hye071/P4P_TMR/Report/P4P_Report_v4.pdf

### Department of Electrical, Computer, and Software Engineering The University of Auckland

# Characterisation, Field Modelling, and Radiation Testing of a Commercial Tunnelling Magnetoresistance (TMR) Sensor for CubeSat Attitude Determination and Control

## Final Year Technical Report

### Sam Ye

### Supervisor: Dariusz Kacprzak

### Project Partner: Daniel Tieu

### [TODO: insert submission date]

## Abstract

Tunnelling magnetoresistance (TMR) sensors offer chip-scale, high-sensitivity magnetic field detection that is attractive for CubeSat attitude determination and control, yet the technology has little space heritage, and little device-level data exists on how a commercial part behaves when it is saturated by a strong field or after irradiation. This report characterises a low-cost commercial TMR sensor, the CT100, using two custom printed circuit boards: a standalone board exposing the raw bridge output, and an integrated board that adds an STM32 microcontroller and an independent current-sense reference to drive and log a controlled test field from a PCB trace. A field model built from the board stack-up and the datasheet position of the sensing element predicts a current-to-output gradient of 1.33 mVA⁻¹
; all nine fitted sweeps lie within −5% to +9% of this prediction, equivalent to a sensitivity of 4.3 to 4.9 mVV⁻¹mT⁻¹
against a typical
datasheet value of 4.5. The saturation ceiling was within about 5% of VDD/3 on every unit and symmetric about zero, and the output settled after saturation within 40 to 85 ms, an upper bound set largely by how quickly the hand-held magnet was withdrawn. At a 10 Hz magnetometer rate this requires the first one to two samples after a saturating event to be discarded. On a fresh sensor, saturation shifted the zero-field output by about 16 mV (roughly 1 mT) while the gradient changed by only 0.5% and the response stayed linear, so the offset must be re-estimated after saturation. After an estimated total ionising dose of up to 40.76 krad(Si), no measurable permanent change was found in the ceiling, recovery or gradient of the three sensors tested, and a ferrite enclosure produced no change that the 12-bit readout could resolve. The results suggest that the CT100 is a promising low-cost COTS candidate for CubeSat magnetometry: its intrinsic noise is low enough to resolve the geomagnetic field, but the unamplified 12-bit readout used here is not, so a gain stage or a higher-resolution converter is required.

ii

## Signed Statement of Contribution

This project was carried out jointly by Sam Ye and Daniel Tieu under the supervision of Dariusz Kacprzak. Sam Ye was responsible for [TODO: list: sensor characterisation, design of both PCBs, firmware, field modelling and Ansys simulation, saturation, radiation, shielding and hysteresis testing]. Daniel Tieu was responsible for [TODO: list: thermal-cycling and temperature-sensitivity testing].

Signed: | Date:

iii

## Contents

Abstract | ii
Signed Statement of Contribution | iii
Glossary of Terms | 1
1 Introduction | 2
2 Literature Review | 2
3 Research Question, Aims, and Objectives | 6
4 The CT100 Sensor | 8
5 Available Instrumentation | 12
6 Standalone Sensor Board | 12
7 Integrated Board: Field Excitation and Design | 15
8 Non-Irradiated Sensitivity and Saturation Characterisation | 20

iv

9 Radiation Testing (Total Ionising Dose) | 24
10 Magnetic Shielding | 28
11 Quantitative Magnetic Hysteresis Testing | 32
12 Discussion | 35
13 Conclusions and Future Work | 43
Acknowledgements | 46
References | 47

v

## Glossary of Terms

ADCS | Attitude Determination and Control System
ADC | Analogue-to-Digital Converter
AMR | Anisotropic Magnetoresistance
COTS | Commercial-Off-The-Shelf
EPS | Electrical Power System
FEM | Finite Element Method
FGM | Fluxgate Magnetometer
GMR | Giant Magnetoresistance
HAL | Hardware Abstraction Layer (STM32 firmware library)

I

2C | Inter-Integrated Circuit (serial communication bus)
INA | Current-sense amplifier (current monitor IC)

krad(Si), Mrad(Si)
| Kilorad / megarad of absorbed dose in silicon – units of Total Ionising Dose
LDO | Low-Dropout (linear voltage regulator)
MCU | Microcontroller Unit
MgO | Magnesium Oxide (crystalline tunnel-barrier material)
MI | Magneto-Inductive (sensor technology)
MTJ | Magnetic Tunnel Junction
OBC | On-Board Computer
PCB | Printed Circuit Board
SWaP-C | Size, Weight, Power, and Cost
SWV | Serial Wire Viewer (ARM Cortex debug trace interface)
TID | Total Ionising Dose
TMR | Tunnelling Magnetoresistance
TRL | Technology Readiness Level
Rad-Hard | Radiation-Hardened

## 1 Introduction

CubeSats are nanosatellites (1–10 kg) built from standardised 10 cm cubic units, offering low-cost, rapid access to space relative to traditional monolithic satellite missions. This miniaturisation is achieved at the expense of severe Size, Weight, Power, and Cost (SWaP-C) constraints, which particularly affect the Attitude Determination and Control System (ADCS): the subsystem responsible for orienting a CubeSat for communications, power generation, and payload pointing. Onboard magnetometers are the primary means by which a CubeSat senses its attitude relative to the Earth’s magnetic field, so the choice of magnetometer technology is central to ADCS performance within a tightly constrained mass, volume, and power budget.

Heritage fluxgate magnetometers offer excellent sensitivity but are too large and power-hungry for CubeSat platforms, motivating a shift toward chip-scale magnetoresistive sensors. Among these, Tunnelling Magnetoresistance (TMR) sensors offer higher sensitivity than AMR or GMR sensors in a footprint of only a few millimetres square. However, TMR remains comparatively immature for space use, typically cited at Technology Readiness Level (TRL) 3, with comparatively little published characterisation data under space-relevant stresses such as strong transient fields from onboard actuators (e.g. magnetorquers) and ionising radiation.

This report documents the design, construction and testing of a project evaluating a commercialoff-the-shelf (COTS) TMR sensor, the CT100, for CubeSat ADCS/EPS applications. Two custom PCBs were developed: a standalone board exposing the raw bridge output, and an integrated telemetry board combining the sensor with microcontroller-based logging and an independent current-based field reference. The research question, objectives and hypotheses that structure the work are set out in Section 3.

A parallel thermal-cycling test campaign investigating TMR temperature sensitivity and thermalshock response was led by project partner Daniel Tieu and is reported separately; it is outside the scope of this report.

The remainder of this report follows the project’s own design and testing sequence. Section 2 reviews the literature and identifies the research gap, and Section 3 states the research question, objectives and hypotheses. Section 4 describes the CT100, Section 5 the instrumentation, and Section 6 the standalone board and the sensor-only saturation tests. Section 7 covers the integrated board, the field model and the firmware. Section 8 presents the non-irradiated saturation recovery and current sweeps and validates the instruments against each other. Sections 9, 10 and 11 cover radiation, shielding and the effect of saturation on the sensor’s offset. Sections 12 and 13 discuss the findings and conclude.

## 2 Literature Review

### 2.1 Magnetometer Technologies for CubeSat ADCS

Fluxgate magnetometers (FGMs) have been used in space exploration for decades: an alternating current drives a coil-wrapped permeable core toward saturation, and an external field produces a measurable imbalance between drive and sense coil currents. FGMs offer excellent sensitivity (of order 10 pT/

√
Hz) but are far too large and power-hungry for CubeSat platforms, typically weighing over 1 kg and drawing more than 10 W [1, 2]. Magneto-inductive (MI) sensors, which sense an external field through the change it induces in the resonant frequency of an LR oscillator, trade sensitivity for a much smaller footprint and lower power draw [1].

Hall-effect sensors are inexpensive and, because they contain no ferromagnetic material, immune to magnetic saturation. However, their comparatively low sensitivity confines them to detecting fields above roughly 1 mT, and while flux concentrators can improve their effective sensitivity, doing so reintroduces the mass and volume penalty that SWaP-C constraints are meant to avoid [3]. Magnetoresistive sensors (AMR, GMR and TMR) instead occupy the submilliTesla sensitivity range needed for geomagnetic-field sensing while remaining chip-scale. AMR sensors (typically permalloy thin films) achieve high resolution and bandwidth but saturate above roughly 1 mT and often require periodic magnetic reset [3]. GMR sensors, based on a multilayer stack of alternating ferromagnetic and non-magnetic conductive layers, offer higher sensitivity again but are more prone to hysteresis-induced offset and can be permanently degraded by strong fields [3]. Chip-scale magnetoresistive sensing has already reached flight heritage: the AMR-based MAGIC instrument, for example, has demonstrated a 104 g, 0.5 W dual-sensor vector magnetometer in orbit on the RadCube CubeSat [4].

TMR sensors extend this trend further. They are built from magnetic tunnel junctions, whose spin-dependent tunnelling through an ultra-thin barrier was first demonstrated by Jullière [5] and made practical at room temperature with crystalline MgO barriers [6,7]. TMR is the newest of the magnetoresistive technologies and is generally cited at TRL 3, compared with TRL 9 for AMR and GMR [8]. The specific device used in this project is described in Section 4.

Two further properties of TMR sensors matter for this project. First, the sensing signal comes from the change in junction resistance between the parallel and antiparallel magnetisation states, usually expressed as the TMR ratio (RAP − RP)/RP [5]; in a packaged bridge sensor this appears as a sensitivity in mV/V/mT. Second, the response depends on the bias voltage across the junctions: Wisniowski et al. found that raising the bias improves sensitivity and field de- ´ tection but worsens nonlinearity and hysteresis [9], so the supply voltage is a design choice rather than a fixed property of the part. Chip-scale magnetoresistive magnetometers already have CubeSat flight heritage. The AMR-based MAGIC instrument flew on CINEMA, where an attitude-independent calibration against the International Geomagnetic Reference Field gave an absolute accuracy within 2% [10], and on RadCube, where both a boom-mounted and an inboard sensor met ESA space-weather measurement requirements [4]. These missions show that low-cost chip sensors can be calibrated in orbit, but they used AMR rather than TMR sensors.

These findings shaped the method in two ways. Because sensitivity depends on the bias across the junctions, every test in this work was run at the same nominal supply of 3.3 V, so that results from different boards and sessions can be compared. Because flight magnetometers correct their offset by in-orbit calibration, the offset and the gradient of the response are measured and reported separately throughout this report.

### 2.2 Radiation Tolerance of TMR Sensors

Because TMR is comparatively new to the space sector, published radiation-tolerance data is limited, though what exists is promising. Alves’ assessment of magnetoresistive sensors for space applications supports the conclusion that TMR devices are radiation-hard [8]. Published testing of TMR magnetic sensors based on MTJ structures found their performance unchanged under bias voltages of +5, 0, and −5V after a Total Ionising Dose (TID) of 5 Mrad(Si) using γ-ray and X-ray sources [11], and MTJs intended for a CubeSat magnetometer have been tested to 100 krad [12]. Ren et al. exposed MgO-barrier MTJs to gamma rays up to 10 Mrad(Si) and found no change in coercivity, exchange coupling or tunnelling magnetoresistance [13], and a 2023 review of MgO-based MTJs under gamma, X-ray and other radiation concluded that they are more tolerant than silicon devices [14]. These doses are well above the 100 krad(Si) level typically used to qualify a device as radiation-hardened. The result is physically consistent with the crystalline MgO barrier at the heart of the MTJ: ionising radiation predominantly damages devices through electron-hole pairs that become trapped at defect sites, permanently shifting threshold voltages, a mechanism that primarily affects the amorphous SiO2 gate oxide used in conventional CMOS devices [15], and for which MgO’s ordered crystal lattice offers far fewer trap sites.

Commercial magnetometers are also routinely radiation-tested before use in space. Regoli et al. irradiated nine PNI RM3100 magnetometers, a COTS magneto-inductive sensor, to 300 krad(Si) and found that most units tolerated the full dose [16], and a commercial CubeSat magnetometer is specified at a component-level TID of 10 krad [17]. Testing several units of a low-cost COTS part is therefore an accepted approach. The tolerance of TMR junctions, however, has mostly been shown for the sensing element itself rather than for a packaged COTS part working in a circuit. Because the literature predicts no permanent change at doses far above the one available here, the test in Section 9 was designed as a comparison against the spread between non-irradiated units and sessions rather than as a search for degradation, and the irradiated sensors were put through exactly the same saturation and current-sweep tests as the non-irradiated ones.

### 2.3 Strong Magnetic Fields on CubeSats and Offset Shift in TMR Sensors

CubeSat magnetometers sit close to magnetic sources, chiefly the magnetorquers used for attitude control, and are therefore usually mounted as far from the spacecraft as possible, ideally on a boom [17]. A typical CubeSat magnetorquer board has a nominal magnetic moment of about 0.2Am²
and can sit inside the electronics stack [18]. The on-axis field of a current loop of radius R carrying current I is B = µ0IR²/
2(r

2 +R

2
)

3/2

[19]. Far from the loop (r ≫ R)

this becomes B = µ0m/(2πr

3
), where m = IπR

2
is the magnetic moment. Applied to the magnetorquer, this gives 5mT at 2cm, 1.5mT at 3cm and 0.3mT at 5cm. These are roughly 5 to 100 times Earth’s field of 25 to 65µT [20], but they are within the CT100’s ±50mT operating range [21]. (The point-dipole estimate overstates the field at distances comparable to the coil size, so these values are an order-of-magnitude guide.) A correctly operating magnetorquer would therefore not normally saturate a TMR sensor, although it would swamp the geomagnetic signal unless the readings are timed around it. Saturation needs a much stronger or closer source, such as a permanent magnet near the sensor, a magnetorquer within about a centimetre, or magnetising equipment during ground handling and test. It is best treated as an off-nominal event, and the questions that matter are whether the sensor survives it and what it leaves behind.

The manufacturer states that its XtremeSense TMR sensors survive any magnetic field amplitude, but notes that after a strong field the offset can shift, that this shift is stable and irreversible, and that, because such events are rare, an offset recalibration is typically recommended [22]. This confirms that the effect is expected, but it gives no magnitude for a specific part and does not consider a platform on which the sensor’s signal is only a few tens of microtesla, where an offset of even one millitesla would dominate. The datasheet quotes a hysteresis error of at most 0.05% for fields within ±20mT [21], but this describes behaviour inside the operating range and says nothing about what remains after the sensor has been driven beyond it. Because in-flight calibration can recover a magnetometer’s offset [10], the question that matters for a CubeSat is not whether such a shift exists but how large it is and whether the rest of the response survives.

This is why the hysteresis test in Section 11 uses a fresh sensor measured before and after saturation in a single session: it is the simplest design that isolates the effect the manufacturer describes and gives it a size.

### 2.4 Comparison of Prior Evidence

The studies above differ in what was tested, and that difference decides how far each applies to a CubeSat that would fly a low-cost COTS TMR part. Table 1 sorts them by the level at which the evidence was obtained: the bare junction, a packaged device, or a complete instrument.

Table 1: Prior evidence relevant to this work, by the level at which it was obtained.

Source | Level tested | Stimulus | Main finding | What it leaves open
Ren et al. [13] | MgO junctions | Gamma rays to
| | 10 Mrad(Si) | No change in
| | | TMR, coercivity or
| | | exchange coupling | Bare junctions: no
| | | | package, bridge or
| | | | readout
Xu et al. [11] | TMR sensors,
| biased | Gamma and X-ray
| | to 5 Mrad(Si) at +5, 0 and −5 V | Performance
| | | unchanged at every
| | | bias | Not a low-cost COTS
| | | | part; saturation not
| | | | tested
Nguyen et al. [12] | Junctions for a
| CubeSat
| magnetometer | To 100 krad | Tolerated | Research devices, not
| | | | a commercial part
Regoli et al. [16] | Packaged COTS
| magnetometer (9
| units) | To 300 krad(Si) | Most units
| | | tolerated the full
| | | dose | Magneto-inductive,
| | | | not TMR
Archer et al. [10]; MAGIC [4] | Complete AMR
| instrument | Flight | 2% absolute
| | | accuracy after
| | | in-orbit calibration | AMR, not TMR;
| | | | offset removed by
| | | | calibration
Allegro AN133 [22]; datasheet [21] | Commercial
| TMR sensors | Strong field | Offset may shift,
| | | stably and
| | | irreversibly; hysteresis ≤ 0.05%
| | | within ±20mT | No size of shift, no
| | | | recovery time, no
| | | | effect on gradient

Wisniowski et ´
al. [9]
TMR sensors | Bias voltage | Higher bias gives more sensitivity but more nonlinearity and hysteresis

Bias must be fixed
and stated

Three patterns follow from Table 1. First, the radiation evidence is strongest where it is least specific. The junction-level studies use doses far above any CubeSat mission, but on bare junctions, while the only packaged-device study reviewed here concerns a different sensing technology. A packaged sensor adds a mould compound, bond wires and a bridge whose four elements must stay matched, so tolerance at the junction level is necessary but not sufficient evidence for the packaged part. Second, the strong-field evidence comes only from the manufacturer and is qualitative. It says that an offset shift can occur, but not how large it is, how long recovery takes or whether the gradient survives, which are the quantities a flight-software designer needs.

Third, the flight results for chip-scale magnetometers show that an offset can be corrected in orbit, so a lasting offset shift is manageable if its size is known, whereas a change in gradient or linearity would be harder to correct. This work therefore tests the packaged CT100 in a circuit, measures offset and gradient separately, and reports recovery in terms of a magnetometer’s sample interval.

### 2.5 Research Gap

Taken together, the literature establishes four things. TMR is among the most sensitive chip-scale magnetoresistive technologies suitable for CubeSat-class ADCS/EPS use (Section 2.1). TMR junctions have been shown to tolerate radiation at the element level, and COTS magnetometers are routinely radiation-tested (Section 2.2). Strong fields are an off-nominal hazard for a CubeSat magnetometer, and the manufacturer acknowledges a lasting offset shift after one (Section 2.3). Yet, in the sources found for this review, no study reports device-level data for a specific low-cost packaged COTS TMR sensor working inside a real circuit that covers
(a) how quickly it recovers from saturation, in terms an on-board computer designer can use,
(b) how large the lasting offset shift is and whether its gradient and linearity survive, and (c) its behaviour after irradiation, using a test method that can be reproduced with ordinary bench equipment. To the best of the author’s knowledge no published study reports these for the CT100. This gap motivates the research question and objectives in Section 3.

## 3 Research Question, Aims, and Objectives

Research question. Is a low-cost, commercial-off-the-shelf TMR sensor (the CT100) operationally viable for CubeSat ADCS/EPS use, specifically with respect to (a) its behaviour when driven into saturation by an unexpectedly strong magnetic field and then recovered, including any lasting change to its output, and (b) any change in its sensing performance following Total Ionising Dose radiation exposure representative of the CubeSat orbital environment?

This question follows directly from the gap identified in Section 2.5: the literature supports TMR’s theoretical suitability and likely radiation tolerance, and the manufacturer acknowledges an offset shift after strong fields, but it does not provide device-level evidence for a specific, inexpensive COTS part of the kind a resource-constrained CubeSat programme would actually select.

Aims. This project aims to generate that device-level evidence for the CT100, and, in doing so, to build and validate a low-cost, automatable test methodology that could be reused for other candidate COTS TMR devices without requiring specialised space-qualification equipment.

Objectives. The research question and aims above translate into the following concrete objectives, which structure the remainder of this report:

(i) characterise the TMR sensor itself, including its operating principle and its saturation ceiling explored in Section 4;

(ii) design and build hardware capable of generating a known, controllable test field and logging the sensor’s response to it automatically, without relying on specialised or costly space-test equipment, this can be found in Sections 5–7;

(iii) quantify the sensor’s sensitivity and saturation-recovery time, and the accuracy of the field model used to drive it, establishing a non-irradiated baseline cross-validated across instruments evaluated in Sections 8 and 8.4;

(iv) measure, with a controlled before-and-after test on a fresh sensor, how saturation changes the sensor’s output offset, gradient and linearity (Section 11);

(v) evaluate the effect of a low-cost ferrite enclosure on the sensor’s zero-field offset and on its response to the test field (Section 10); and

(vi) assess the sensor’s tolerance to Total Ionising Dose radiation representative of the Cube-Sat orbital environment, with and without magnetic shielding, against the same validated methodology (Section 9).

### 3.1 Hypotheses

The objectives above are tested through six hypotheses. Each one is stated with the criterion used to judge it, so that the results can support or reject it, and each is linked to the section where it is tested.

H1: Saturation ceiling. The output saturates at Vout = ±VDD/3, as derived from the bridge topology in Section 4.3, and the positive and negative ceilings are equal in magnitude. It is supported if every measured ceiling lies within a few percent of VDD/3, allowing for the tolerance of the element resistances.

H2: Field model and sensitivity. The gradient of Vout against trace current matches the gradient predicted from the field model and the datasheet sensitivity. It is supported if the measured gradient corresponds to a sensitivity inside the datasheet range of 3.8 to 5.2mVV⁻¹mT⁻¹ (explored in Section 8.3).

H3: Saturation recovery. After saturation the output returns to its baseline within one sample interval of a typical CubeSat magnetometer read at 10 Hz (100ms), so no samples need to be discarded. It is supported if the worst-case recovery time, including a safety margin, is shorter than this interval (Sections 6.3 and 8.2).

H4: No lasting effect of saturation. Driving the sensor into saturation leaves no lasting change. It is supported if, on a sensor with no magnetic history, the zero-field baseline after saturation is within one ADC step of the baseline before saturation and the gradient is unchanged within session-to-session variation (Section 11).

H5: Radiation tolerance. A total ionising dose of 40.76krad(Si) causes no measurable permanent change, as the literature on MgO-barrier MTJs predicts (Section 2.2). It is supported if the saturation ceiling, recovery time and gradient of irradiated sensors differ from non-irradiated sensors by less than the variation between non-irradiated units and sessions (Section 9).

H6: Shielding. The ferrite enclosure can affect the measurement in two ways, and each is judged against the resolution of the method. (a) Attenuation of the ambient field. Diverting the ambient field around the sensor removes its contribution to the zero-current offset. Earth’s field along the sensing axis contributes at most about 1 mV at the CT100’s sensitivity, less than one ADC step, so this effect is supported only if the offset changes by more than one ADC step (1.61mV); a smaller change is treated as unresolved, not as evidence against shielding. (b) Disturbance of the test field. High-permeability material near the trace could concentrate or divert the trace’s own field and so change the gradient. The enclosure is judged not to disturb the test field if the gradient changes by less than the session-to-session variation (Section 10).

## 4 The CT100 Sensor

### 4.1 Device Overview

The CT100LW-FS6 tunnel magnetoresistance (TMR) sensor was selected for its wide temperature range, differential output, small footprint and cost. It is rated from −40 ◦C to 150 ◦C [21], which also suited the thermal-cycling work of project partner Daniel Tieu. Its differential output rejects noise common to both outputs, and it has an operating range of ±50mT with a linearity error of ±0.5% between −20 and +20mT [21].

A discrete bridge sensor was chosen over integrated TMR sensor ICs, which add on-chip amplification and processing, because the aim was to characterise the raw behaviour of the TMR elements. A discrete bridge exposes that behaviour directly and leaves the choice of readout to the system designer. Its SOT23-6 package keeps footprint and mass small, in line with the size, weight and power (SWaP) constraints of CubeSats, and at a unit cost of $0.92 from DigiKey in April 2026 [23], enough units could be bought for irradiation and destructive testing.

The CT100 operates from 1.0 to 5.5 V [21]. Its sensitivity is ratiometric, scaling in proportion to VDD, so a higher supply gives a larger output per unit field. A supply of 3.30 V was nevertheless chosen to match the STM32 microcontroller, which removes the need for a second regulator or level shifting and lets the sensor share the ADC’s reference voltage.

The datasheet also gives the electrical characteristics used later in this report: a bridge resistance of 20 to 40 kΩ, a typical power consumption of 0.30 mW at VDD = 3.0V, a zero-field offset of at most ±5mVV⁻¹

, a sensitivity of 3.8 to 5.2 mVV⁻¹mT⁻¹ (typically 4.5), a hysteresis error of at most 0.05% within ±20mT, and an output noise of 700 nV/

√
Hz at 10 Hz [21].

### 4.2 Physical Operating Principle

The CT100LW-FS6, like other TMR devices is built around magnetic tunnel junctions (MTJs): a pinned ferromagnetic reference layer, an ultra-thin (~2 nm) insulating crystalline magnesium oxide (MgO) layer and a magnetically free ferromagnetic layer [6, 7].

Conduction across the junction is by quantum tunnelling: electrons have a finite probability of passing through the thin MgO barrier. Figure 1 shows the junction and its equivalent circuit.

The magnetisation of the reference layer is fixed, while that of the free layer rotates in response to an external field. Tunnelling is spin-dependent, so the junction resistance depends on the angle between the two magnetisations. When they are parallel, many electrons find matching spin states on the far side of the barrier, the tunnelling current is high, and the resistance is at its minimum, RP. When they are antiparallel, fewer states match and the resistance rises to its maximum, RAP [5]. The size of the effect is the TMR ratio, (RAP −RP)/RP. Between these extremes the resistance varies smoothly with the field component along the sensing axis. A field

V + DD

i

R | ≡ | −
V | + DD

i

Top Ferromagnetic Layer
MgO Layer
Bottom Ferromagnetic Layer

R

Figure 1: Equivalent electrical circuit model equating a standard variable resistor (left) to the physical three-layer Magnetic Tunnel Junction stack structure (right).

perpendicular to that axis pushes the free layer towards neither the parallel nor the antiparallel state, so to first order it does not change the resistance. A TMR element can therefore be modelled as a resistor whose value is set by the strength and direction of the field along one axis.

Figure 2 shows how this makes a linear sensor. At zero field the free layer rests perpendicular to the reference layer, at a resistance R⊥ between the two extremes. A field along the sensing axis rotates it towards the parallel or the antiparallel state, and once it is fully aligned the resistance stops changing: the element is saturated. In a simple model the conductance of the junction varies with the cosine of the angle θ between the two layers, G = G⊥(1 + k cosθ), and cosθ grows in proportion to the field until it reaches ±1. The datasheet values RP = 20kΩ and RAP = 40kΩ give k = 1/3 and R⊥ = 2RPRAP/(RP+RAP) ≈ 26.7kΩ. In the bridge of Section 4.3 this model makes the output exactly proportional to cosθ, reaching VDD/3 when every element is saturated, so the typical sensitivity of 4.5mVV⁻¹mT⁻¹
implies that the elements saturate at about 1/(3×0.0045) ≈ 74mT, beyond the ±50mT operating range. The model is a guide only; a real element rounds off as it approaches saturation.

B ≤ −Bsat
Antiparallel, RAP

B = 0
Perpendicular, R⊥

B ≥ +Bsat
Parallel, RP

Free layer
MgO barrier
Reference layer

Pinning layer

(a) Increasing field B along the sensing axis

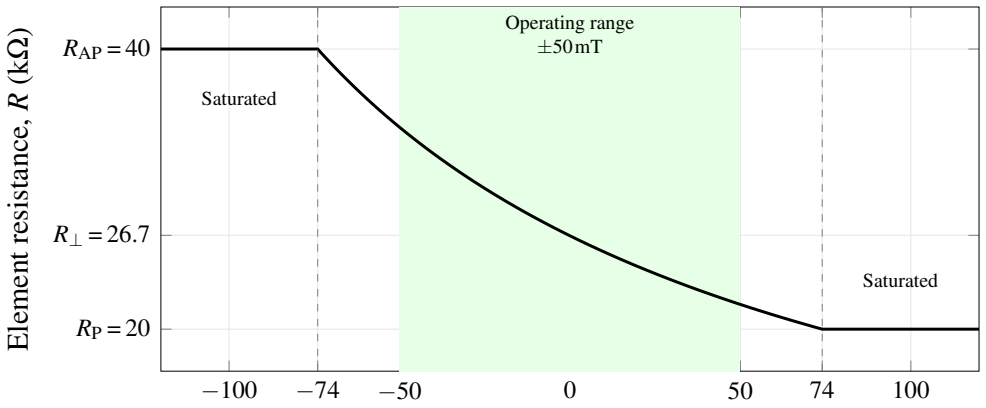
[picture p40: figure]
RAP = 40; Operating range ±50mT; Saturated; Element resistance,

Field along the sensing axis, B (mT)

(b) Resistance of one element (simple model)

Figure 2: (a) Magnetisation of the free layer relative to the reference layer as the field along the sensing axis increases. (b) Resistance of one element in the simple cosine model, using the datasheet RP and RAP and the saturation field of about 74mT implied by the typical sensitivity. The shaded band is the datasheet operating range. Elements on the other side of the bridge follow the mirror image of this curve.

### 4.3 Bridge Topology, Output Convention, and Saturation Ceiling

The CT100LW-FS6, referred to from here as the CT100, arranges four such elements in a passive Wheatstone bridge (Figure 3).

To predict the maximum differential output voltage prior to saturation, the CT100’s internal TMR Wheatstone bridge (Figure 3a) was evaluated theoretically. An equivalent schematic with explicitly labeled internal elements is provided in Figure 3b to aid in following the derivation below. According to the device datasheet [21], the per-element resistance ranges from Rmin ≈ 20kΩ (parallel magnetic alignment, lowest-resistance state) to Rmax ≈ 40kΩ (antiparallel magnetic alignment, highest-resistance state).
As a result of this Wheatstone-bridge configuration, the largest change in |Vout| is VDD
3

:

|∆Vout,max| =

VDD
3

(1)

The maximum output swing is bounded by the resistance range of each element, from Rmin ≈ 20kΩ to Rmax ≈ 40kΩ.


(a) CT100 internal Wheatstone-bridge.

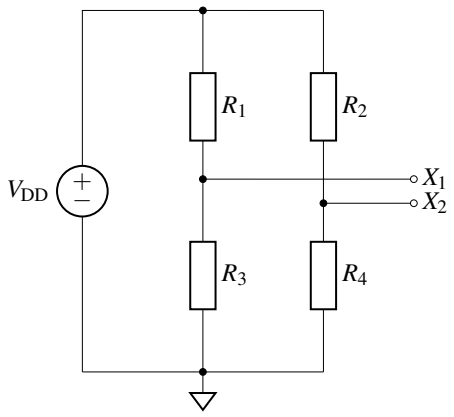
[picture p41: figure]

(b) Equivalent bridge schematic.

Figure 3: Internal CT100 IC pin configuration alongside its labeled equivalent electrical schematic.

The voltage potentials at the two central output nodes, X1 and X2, as seen in Figure 3b are determined by the independent voltage divider ratios along the bridge:

X1 = VDD ·

R3
R1 +R3
, X2 = VDD ·
R4
R2 +R4
(2)

The general differential output voltage Vout across nodes X1 and X2 is expressed as:

Vout = X1 −X2 = VDD
R3
R1 +R3

−

R4
R2 +R4
(3)

At B = 0T, all four TMR elements exhibit nominal, equal resistance (R1 = R2 = R3 = R4), yielding balanced potentials X1 = X2 =

VDD
2

and Vout = 0V.

A key operational characteristic of the CT100 is that an external magnetic field applied along its sensitive axis drives opposing element pairs in opposite resistance directions. As one pair (R1,R4) decreases toward Rmin, the complementary pair (R2,R3) increases toward Rmax or vice versa. This response is governed by the orientation of the pinned ferromagnetic reference layer within each TMR element: R1 and R4 share an identical reference layer alignment, whereas R2 and R3 are pinned in the opposite direction.

At full magnetic saturation, the opposing resistor pairs settle at either Rmin and Rmax. For this derivation, an external magnetic field polarity is assumed such that:

R1 = R4 = Rmin, | and R2 = R3 = Rmax | (4)

Substituting these saturation values into Equation 2 gives the node potentials at full saturation:

X1,sat = VDD ·

Rmax

Rmin +Rmax
, | X2,sat = VDD ·
Rmin

Rmax +Rmin
(5)

Subtracting X2,sat from X1,sat yields the maximum theoretical differential output voltage Vout,sat:

Vout,sat = X1,sat −X2,sat = VDD Rmax −Rmin

Rmax +Rmin
(6)

Substituting the CT100 datasheet resistance values [21] (Rmin = 20kΩ and Rmax = 40kΩ):

Vout,sat = VDD
40kΩ−20kΩ
40kΩ+20kΩ

= VDD
20

60
=

VDD
3

(7)

The output is therefore bounded to |Vout| ≤ VDD/3. For VDD = 3.30V the ceiling is 1.10V; this is tested in Section 6.3.

The direction of the applied field along the sensitive axis decides which resistor pair moves to Rmin, so the bridge can saturate at either polarity. The two limits, Vout = +VDD/3 and Vout = −VDD/3, are called the positive ceiling and the negative ceiling respectively. The negative ceiling follows from the derivation above by swapping Rmin and Rmax. In this report, ceiling means the saturation limit of Vout, and its sign states which of the two was reached.
From here on, the sensor output is defined as Vout = X1 −X2 for every instrument used (DMM, oscilloscope and MCU).

## 5 Available Instrumentation

Characterization and bench-top tests were conducted using the following laboratory equipment to ensure power delivery and take measurements.

- Digital Oscilloscope: Rohde & Schwarz RTB2002 (2.5 GS/s sampling rate, 10-bit A/D converter) for transient analysis, step-response monitoring across nodes X1 and X2.
- Digital Multimeter (DMM): Keithley 2110 5¹
2 Digit Dual-Display Multimeter for DC Voltage and Current logging and cross-validating MCU reading accuracy.
- DC Power Supply Unit (PSU): Topward dual-tracking linear DC power supply capable of supplying up to 6.0 A continuously, providing supply voltage and current excitation through the PCB test trace.

## 6 Standalone Sensor Board

Before adding any electronics, the bare sensor was characterised on its own. This gives a reference for how the CT100 itself behaves, so that any later change in behaviour can be attributed to the circuit, to radiation or to saturation rather than to the sensor. The results answer H1 (the saturation ceiling) and give the first measurement for H3 (recovery time).

### 6.1 PCB Design

To measure the CT100’s saturation limits and test the derivation in Section 4.3, a standalone board was designed in Altium Designer and populated with only the CT100 and a 0.1 µF decoupling capacitor.

The board is powered from a laboratory PSU, and the outputs X1 and X2 are measured with the oscilloscope and the DMM. No amplifier was included, because an amplifier’s slew rate and bandwidth could slow the measured recovery and hide the response of the bridge itself.

Measuring the unconditioned bridge therefore gives a baseline for the sensor’s own saturation and recovery. The same board was used by Daniel Tieu for thermal cycling, and it is shown in Figure 4.


Figure 4: Standalone Sensor PCB

### 6.2 Saturation Testing Methodology

Saturation was induced with a hand-held LM-1618 neodymium magnet, the simplest stimulus available for a first characterisation, although it is neither repeatable nor automatable. The aim was to drive the sensor well beyond its ±50mT operating range, to characterise recovery after the worst case, while staying near or below its ±200mT absolute-maximum rating, above which reliability may be affected [21].

The magnet used was an LM-1618 neodymium disc, 25 mm in diameter and 5 mm thick, with a remanence Br of 1180 to 1220 mT [24]. The remanence is a property of the material, not the field outside the magnet. On the axis of a disc magnet of radius R and thickness L, treating the magnet as an ideal solenoid [25, 26], the field at distance z from its face is

B(z) = Br
2

"
L+z
p
R² + (L+z)

2

−

z
√
R² +z

2

, | (8)

which gives about 223 mT at the face, 152 mT at 5 mm and 86 mT at 10 mm. Within about a centimetre the field is therefore well beyond the CT100’s ±50mT operating range, which guarantees saturation, while staying close to or below its 200 mT absolute-maximum rating [21], since the package itself keeps the sensing element away from the magnet face.

During each test the oscilloscope confirmed that the output had reached the ceiling of about VDD/3 derived in Section 4.3. The magnet was then removed quickly, and the oscilloscope captured the output as it fell back to its zero-field baseline.

Every saturation result in this report is presented in the same table format, with the same definitions:

- Sample: the unit tested. Samples 1 to 4 are sensor-only boards (1 and 2 non-irradiated, 3 and 4 irradiated). Boards A, B and C are integrated boards (A non-irradiated, B irradiated, C a fresh sensor used for the hysteresis test in Section 11).
- Ceiling (V): the output voltage Vout reached at saturation. Its sign shows which ceiling was reached, so each sample has one row per ceiling.
- Baseline (mV): the output once it has settled after the field is removed.
- Swing (V): the size of the drop from the ceiling to the baseline, |ceiling−baseline|.
- Recovery (ms): the time from the start of the fall until the output has settled at its baseline. On the oscilloscope this is read with cursors; for the MCU (SWV) traces it is the time until the output stays within 5mV of its final baseline. Five millivolts is also about the oscilloscope’s vertical resolution at 500mV/div, so the two definitions of “settled” are comparable.

### 6.3 Sensor-Only Saturation and Recovery Behaviour

Two non-irradiated sensor-only samples (Samples 1 and 2) were each driven to both ceilings. Testing both directions checks a prediction of the bridge model: the ceilings should be symmetric about zero, ±VDD/3 (Section 4.3), because the same spin-tunnelling limit applies to either polarity. The extracted values are listed in Table 2, and the oscilloscope captures they come from are shown in Figure 5.

The CT100 is sensitive to the field component along one in-plane axis of its package. The datasheet defines a positive field as one directed into the pin 1/pin 6 side of the package, which makes X1 > X2 [21]. Which ceiling is reached therefore depends only on which pole of the magnet faces that side of the package: one pole drives Vout to the positive ceiling and the opposite pole to the negative ceiling.

Table 2: Saturation recovery results, non-irradiated sensor-only samples.

Sample Ceiling (V) Baseline (mV) Swing (V) Recovery (ms)

1 | −1.126 | −17.4 | 1.108 | 76.5
1 | +1.125 | −12.5 | 1.138 | 74.0
2 | −1.145 | −17.4 | 1.128 | 76.0
2 | +1.125 | −12.5 | 1.138 | 67.5

Figure 5 shows the oscilloscope captures for Samples 1 and 2 at both ceilings. The blue trace (M1) is the differential output Vout = X1 −X2, and the yellow (C1) and green (C2) traces are the bridge outputs X1 and X2.


(a) Sample 1: Negative Saturation Recovery | (b) Sample 1: Positive Saturation Recovery


(c) Sample 2: Negative Saturation Recovery | (d) Sample 2: Positive Saturation Recovery

Figure 5: Oscilloscope traces capturing the saturation ceiling and subsequent transient recovery for the non-irradiated sensors.

Across the four captures the mean recovery time is 73.5ms, with a maximum of 76.5ms. Because the magnet was withdrawn by hand, these times include the effect of the withdrawal speed. What they mean for a CubeSat magnetometer, including the guard window that flight software would need after a saturating event, is assessed in Section 12.3 once all samples have been presented.

## 7 Integrated Board: Field Excitation and Design

A hand-held magnet cannot produce a known field, so it cannot measure sensitivity, and it cannot be automated. The integrated board solves both problems: a current-carrying trace produces a field that can be calculated from the measured current, and the microcontroller logs the sensor output without an operator. This board is the low-cost, reusable test method named in the aims, and it is used for every test of sensitivity (H2), lasting change (H4), radiation (H5) and shielding (H6).

### 7.1 Integrated Board Design

Measuring sensitivity needs a repeatable test field of known size. It is produced by a current-carrying trace routed directly beneath the sensor. The field of the trace is calculated analytically

(Section 7.3) and simulated in Ansys Maxwell (Section 7.4), giving a theoretical benchmark for the measured output. The PSU’s 6.0 A limit gives a field of only about 0.5 mT, far too small to saturate the sensor, but enough for a linear sweep from which the sensitivity is found. This sweep is the baseline against which any change caused by saturation or radiation is later measured.

The integrated board is built around three components:

- Microcontroller (MCU): An STM32G431KBT6 [27] reads the CT100’s outputs directly on a differential ADC channel, at 1.0 kHz with 12-bit resolution. The ADC’s built-in calibration runs at start-up to reduce differences between boards.
- Current Monitor (INA219) [28]: Because the PSU’s analogue display was not precise enough, the trace current is measured by an INA219 across a Kelvin-connected 5.0 mΩ shunt. The measured current is used to calculate the field applied to the sensor.
- Low-Dropout (LDO) regulator: A 5.0 V input is regulated to 3.30 V, which supplies both the sensor and the MCU. The regulator’s power-supply rejection keeps supply noise out of the bridge, and because the same rail is the ADC’s reference, its value sets the size of one ADC step.

As Figure 6 shows, the current-carrying trace (blue polygon) runs on the bottom layer, in series with a 2512 shunt resistor. Figure 7 defines the positive current direction (+i) used for all field calculations and sweeps. The full Altium schematic is in Appendix A.

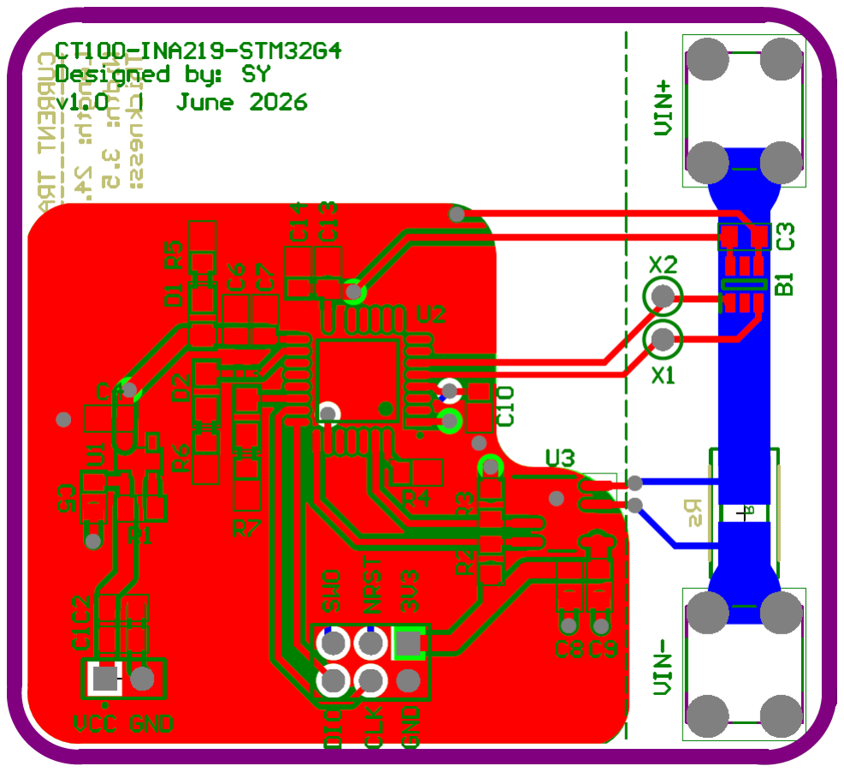
[picture p42: figure]

Figure 6: Integrated board layout (left) and rendered assembly view (right).

Figure 7 models the excitation as an ideal current source i; in practice a bench PSU in constantcurrent mode sets the current through Rshunt and the trace.

### 7.2 PCB Trace Design

The current-carrying trace is routed on a four-layer PCB whose stack-up is given in Table 3, so that its field lies along the sensor’s sensing axis.

V

+
IN

V

−
IN

+i

R | i shunt

Figure 7: Field excitation circuit schematic and positive trace current convention (+i).

No copper pour was placed on any layer directly beneath the sensor, so that no plane or return currents flow close to the sensing element and the only board-generated field at the die is that of the excitation trace. Copper is non-magnetic, so the concern is current flowing in nearby copper rather than the copper itself distorting a static field.

Table 3: Four-layer PCB stack-up, from the Altium Layer Stack Manager.

Layer | Material | Type | Thickness (mm) | Dk
Top solder mask | SM-001 | Solder mask | 0.0254 4.0
Top layer | CF-004, 1 oz | Signal | 0.0350 | —
Dielectric 4 | PP-017 | Prepreg | 0.1295 4.3
Dielectric 2 | PP-017 | Prepreg | 0.1295 4.3
Layer 2 (GND) | CF-001, 1/4 oz Signal | 0.0090 | —
Dielectric 1 | FR-4 | Core | 0.3200 4.8
Layer 3 (PWR) | CF-001, 1/4 oz Signal | 0.0090 | —
Dielectric 3 | PP-017 | Prepreg | 0.1295 4.3
Dielectric 5 | PP-017 | Prepreg | 0.1295 4.3
Bottom layer (trace) CF-004, 1 oz | Signal | 0.0350 | —
Bottom solder mask SM-001 | Solder mask | 0.0254 4.0
Total | | | 0.9770

The board is 0.977mm thick in total: 0.088mm of copper and 0.838mm of dielectric, made up of four 0.130mm prepreg layers and a 0.320mm FR-4 core. The excitation trace is on the bottom layer, with a width w = 3.5mm, sized to carry the PSU’s 6.0A limit.

### 7.3 Analytical Field Model

The horizontal magnetic field at the sensing element, a height d above the centre of the trace of width w = 3.5mm, is modelled as the field of a thin flat strip conductor:

Bplanar = µ0

I

πw

arctan w
2d

. | (9)

The trace is treated as a thin flat strip of width w carrying the current I uniformly, so it can be split into long straight filaments of width dx, each carrying dI = (I/w)dx. A long straight filament produces a field µ0 dI/(2πr) at distance r [19]. At a height d above the centre of the strip, the vertical components from filaments on either side cancel by symmetry, and the horizontal components add, so

B =

Z w/2

−w/2

µ0I
2πw

d
x

2 +d

2

dx =

µ0I

πw

arctan w
2d
, | (10)

which is Equation (9).

The distance d is measured from the mid-plane of the bottom-layer trace to the sensing element. From Table 3, that mid-plane lies 0.909mm below the top copper surface: half of the 0.035mm trace, the 0.838mm of dielectric, the two 0.009mm inner copper layers and the 0.035mm top copper. The datasheet places the sensing element 0.76 ± 0.087mm above the bottom of the SOT23-6 package body, and the body stands a typical 0.10mm (0 to 0.15mm) above the board [21]. The sensing element is therefore hs ≈ 0.86mm above the top copper, and

d = 0.909mm+hs ≈ 1.77mm. | (11)

The solder joint under the leads adds a few tens of micrometres and is neglected. Taking the tolerances on the sensor position and the package stand-off together, d lies between 1.58 and 1.91mm.

Normalizing Equation (9) by the trace current I yields the geometric field coupling coefficient kB:

kB =

Bplanar
I

=

µ0
πw

arctan w
2d
≈ 0.0892mTA⁻¹
, | (12)

with a range of 0.085 to 0.096mTA⁻¹ over the tolerance on d. At a representative excitation current of I = 4.175A this gives a field of 372µT. Combining kB with the CT100 sensor’s sensitivity SV (mVmT⁻¹
) gives the expected differential voltage change per unit trace current:

∆Vout
∆I
= kB · SV . | (13)

This analytical transfer ratio serves as the theoretical benchmark against which both the Ansys Maxwell finite-element simulations and empirical linear current sweeps are validated.

### 7.4 Simulated vs. Experimental Field Validation

The analytical field model was cross-checked against a finite-element simulation in Ansys Maxwell (Figure 8), which resolves the full 3D field around a trace of finite length rather than the infinite strip assumed by Equation (9). The field was evaluated at I = 4.175A on a 2.9 × 2.8mm sheet through the position of the sensing element, d = 1.77mm above the mid-plane of the trace. Across this sheet the simulated field ranges from 328 to 532µT, which brackets the analytical value of 372µT at the sensing element. [TODO: Read the simulated value at the sensing-element point itself (trace centre, 1.77 mm above the trace mid-plane) and compare it with 372 µT in one sentence.]

The measured output at 4.175A (about 16mV on the DMM) cannot be compared directly with the model, because it includes the sensor’s zero-field offset of about 13mV on this board. The like-for-like comparison is the gradient of output against current, which a fixed offset does not affect. It is made in Section 8.3, where the measured gradient agrees with the model to within a few percent.

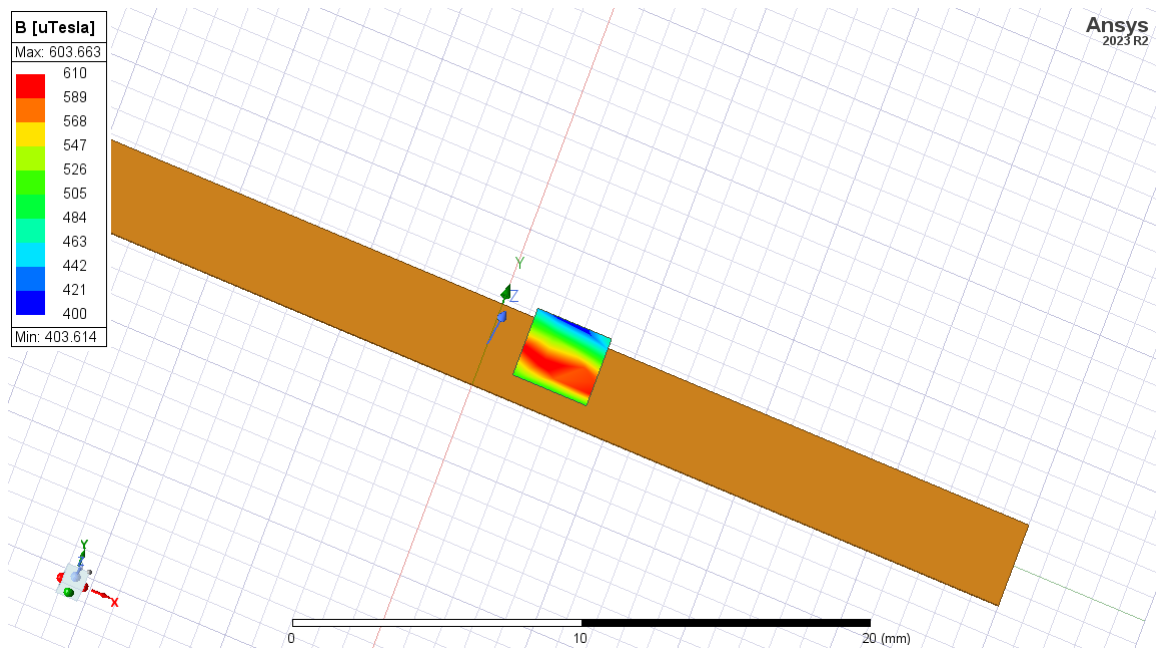
[picture p43: figure]

Figure 8: Ansys Maxwell simulation of the trace field at I = 4.175A, evaluated on a sheet through the position of the sensing element.

### 7.5 Firmware

The firmware is built upon the STM32 Hardware Abstraction Layer (HAL). The MCU’s ADC is configured in differential-pair mode, sampling X1 −X2 directly and converting the raw 12-bit value to volts via:
X1 −X2 =
ADCraw −2048
2048 |
×VDD | (14)

where 2048 is the mid-scale ADC code corresponding to the zero-differential (balanced-bridge) midpoint. Hardware ADC self-calibration (HAL_ADCEx_Calibration_Start) is executed automatically on every boot before any conversions occur. The MCU continuously polls the INA219 over I²C for trace current and streams both the current and voltage values out in real time over the Serial Wire Viewer (SWV) debug channel for offline analysis in MATLAB.

### 7.6 Design Note for Future PCB Revisions

Because the sensor bridge is nominally balanced at VDD/2 as noted in Section 4.3, the ADC channel monitoring it spends its full dynamic range on either side of that midpoint. Any measurement taken near the zero-differential code inherits the ADC’s own quantization and calibration uncertainty around that center point.

A future revision of the integrated board could add a small reference offset at the ADC input, so that zero field no longer sits exactly on the mid-scale code. This should reduce the error from operating at the ADC’s most quantisation-sensitive point; it was not implemented or tested in this project.

## 8 Non-Irradiated Sensitivity and Saturation Characterisation

### 8.1 Linear Fitting and the Coefficient of Determination

Every current sweep in this report is summarised by a straight line,

Vout = mI +c, | (15)

where m is the gradient in mVA⁻¹
and c is the offset, the output at zero trace current. The line is fitted by ordinary least squares, which chooses m and c to minimise the sum of the squared differences between the measured outputs Vi and the fitted values Vˆ
i = mIi +c.

How well the line describes the data is given by the coefficient of determination,

R

2 = 1−

∑i

(Vi −Vˆ
i)

2
∑i

(Vi −V¯)
2
, | (16)

where V¯ is the mean of the measured outputs. The numerator is the scatter left over after the fit and the denominator is the total spread of the data, so R

2
is the fraction of the variation in the output that the straight line explains. A value of 1 means every point lies exactly on the line; a value of 0 means the line explains none of the variation. In this report R

2
| is used only as a
measure of linearity. A high R

2
shows that the output is proportional to current over the sweep, but it does not show that the gradient is correct; that is checked separately against the theoretical gradient. R

2
is also unaffected by a constant offset, so a sweep with a large zero-field offset can still have R

2
close to 1.

The uncertainty of each gradient is given by its standard error,

sm =

s
∑i

(Vi −Vˆ
i)

2/(n−2)
∑i

(Ii − ¯I)
2
, | (17)

where n is the number of points in the sweep (13 for every sweep here). Gradients are reported as m±sm. Two gradients are treated as different only if they differ by clearly more than their combined standard error, q
s

2
m,1 +s

2
m,2

### 8.2 Saturation Recovery on the Integrated Board

This subsection repeats the saturation test on the integrated board, with the output logged by the MCU instead of the oscilloscope, so that the two hardware configurations can be compared. The board was run from a regulator input of VCC = 4.97V, giving a sensor supply of VDD = 3.32V.

Table 4: Saturation recovery results, non-irradiated integrated board (Board A).

Sample Ceiling (V) Baseline (mV) Swing (V) Recovery (ms)

A | −1.152 | −8.1 | 1.144 | 65.2
A | +1.138 | +12.9 | 1.125 | 60.2

(a) Non-irradiated, negative saturation recovery
(b) Non-irradiated, positive saturation recovery

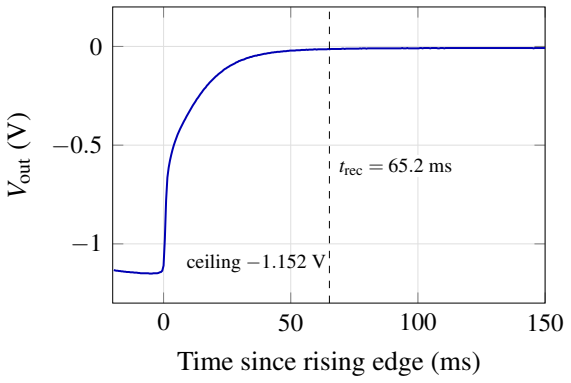
[picture p44: figure]
trec = 65.2 ms; ceiling −1.152 V; Time since rising edge (ms); Vout (V)
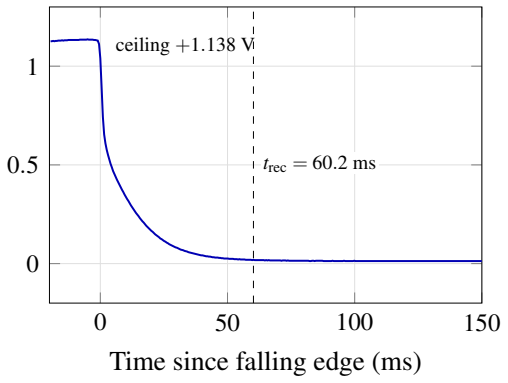
[picture p45: figure]
trec = 60.2 ms; ceiling +1.138 V; Time since falling edge (ms)

Figure 9: Non-Irradiated Saturation recovery on the integrated board after the magnet is removed, for both field directions.

The integrated board reproduces the standalone results (Section 6.3). Its ceilings of −1.152V and 1.138V are within about 1% of the −1.145V and 1.125V reached by the sensor-only samples, and are again symmetric about zero. Its recovery times of 60.2 and 65.2ms are slightly shorter than the 67.5 to 76.5ms of the sensor-only samples. Because the magnet was withdrawn by hand in both cases, this difference is within what the withdrawal speed alone could cause (Section 12.3).

### 8.3 Current Sweep: Data and Sensitivity Fit

The current-sweep output was logged over SWV, exported and processed in MATLAB. Each current setting was held for 20 s and the readings were averaged. Single readings were not used because, at a fixed current, the ADC output hops between a few codes, typically spanning one to two steps of 1.61 mV around the true mean. On this board the saturation test was performed before the current sweep, so the sweep includes any offset shift caused by saturation (Section 11).
The trace current was swept from −3.0 to +3.0A in approximately 0.5 A steps, all within a single session at VDD = 3.32V (Table 5).

Table 5: Non-Irradiated & No Shielding Current Sweep Data

DMM Current (mA) | INA Current (mA) | DMM (mV) | MCU (mV) | Scope (mV)
−2991.0 | −2966.7 | 8.634 | 8.069 | −12.207
−2498.5 | −2478.2 | 9.860 | 9.571 | −10.986
−2029.0 | −2012.6 | 9.950 | 9.584 | −10.376
−1501.0 | −1487.7 | 11.690 | 11.249 | −9.766
−1022.0 | −1016.6 | 11.250 | 11.107 | −9.308
−499.0 | −498.2 | 12.650 | 12.022 | −10.681
−0.7 | −6.3 | 12.980 | 12.847 | −8.594
499.0 | 487.8 | 14.450 | 13.628 | −7.477
1022.0 | 1005.2 | 14.210 | 13.796 | −5.035
1501.0 | 1477.2 | 15.697 | 14.790 | −6.104
2029.0 | 2002.1 | 15.720 | 15.020 | −3.516
2498.5 | 2466.4 | 16.500 | 16.068 | −3.906
2991.0 | 2954.8 | 16.570 | 16.088 | −5.030

A linear fit of Vout against trace current gives a gradient (the sensitivity to trace current) of 1.356 mVA⁻¹ on the DMM and 1.315 mVA⁻¹ on the MCU.

The CT100 datasheet [21] specifies a typical full-bridge sensitivity of 4.5 mVV⁻¹mT⁻¹
, with
a specified range of 3.8 mVV⁻¹mT⁻¹

to 5.2 mVV⁻¹mT⁻¹
. At the 3.32 V supply voltage used for this characterisation, the corresponding theoretical voltage sensitivity is therefore

SV,theory = SCT100VDD =

4.5mVV⁻¹mT⁻¹

(3.32V) = 14.94mVmT⁻¹
. | (18)

The analytical field model in Equation (9) gives a field coefficient of approximately 0.0892 mTA⁻¹ for the trace geometry used in the test. Combining this field response with the CT100 sensitivity gives the expected voltage change per unit trace current:

∆Vout
∆I

= SV,theory

∆B
∆I

=

14.94mVmT⁻¹

0.0892mTA⁻¹

= 1.332mVA⁻¹
. (19)

Thus, for a given trace current, the theoretical sensor output can be written as

Vout,theory = V0 +

1.332mVA⁻¹
I, | (20)

where V0 is the zero-field output voltage. Figure 10 below uses a V0 value of 12.980 mV to visually compare the voltage slope; it is not a theoretical prediction of the CT100 offset voltage. Figure 11 plots how close the INA device follows the DMM measurement.

Trace current, I (mA); Vout (mV); Vout vs. Trace Current; Theoretical VO = 12.980mV; Theoretical VO = 0 mV; DMM; MCU

Scope

Figure 10: Voltage cross-validation during the non-irradiated, unshielded current sweep. The dashed lines shows the theoretical CT100 responses.

Measurement Instance; Trace Current (mA); Current Cross-Validation; DMM; INA219

Figure 11: Current cross-validation across the 13-point sweep.

The theoretical current-to-voltage gradient at VDD = 3.32V is 1.332mVA⁻¹ (Equation (19)).
The measured DMM gradient (1.356 ± 0.067mVA⁻¹
) is 101.8% of this value and the MCU gradient (1.315±0.055mVA⁻¹
) is 98.7%; both differences are smaller than the standard error of the fit. Expressed as sensitivities these are 4.58 and 4.44mVV⁻¹mT⁻¹
, close to the datasheet
typical value of 4.5. The tolerance on the sensor’s height in its package (Section 7.3) gives a predicted gradient of 1.27 to 1.43mVA⁻¹
(−5% to +7%), so the measurement agrees with the model within both the measurement and the model uncertainty.

### 8.4 Instrumentation Validation

The sweep also compares the three instruments, using Figure 10 for voltage and Figure 11 for current.

Voltage. The DMM and MCU readings track one another closely: across the 13 points the mean difference is about 0.5mV and the largest is 0.9mV, less than one ADC step (1.61mV). The oscilloscope disagreed with both, showing a current-dependent response that went negative. A likely cause is that its two channels are referenced to separate ground clips, so ground-return drops that grow with the trace current appear differently on each channel before they are subtracted. Because the DMM and MCU agree, the oscilloscope was not used for any later DC measurement. It was kept for transients, where its time resolution is needed.

Current. The INA219 tracked the DMM with a near-unity relationship across the full sweep, with a largest difference of 36.2mA. Because the INA219 is part of the board, it was used as the current reference for all later sweeps, which removed the need to log the DMM alongside it and shortened each test.

The saturation events were also found to move the zero-field baseline of the sensor. This is quantified in a dedicated before-and-after test in Section 11, and its consequences are discussed

in Section 12.4.

## 9 Radiation Testing (Total Ionising Dose)

### 9.1 Rationale and Test Isolation Strategy

Crystalline MgO, the MTJ’s insulating barrier, is expected to be far more tolerant of ionising radiation than the amorphous SiO2 used in conventional silicon devices (Section 2.2). Only the CT100 sensors were irradiated, not the boards, so that any change could be attributed to the sensor rather than to the microcontroller, regulator or current monitor, which are conventional silicon devices and more likely to be affected.

### 9.2 Experimental Setup

Ten CT100 sensors were exposed using a 320 kV tube potential (tungsten target, 30◦ anode
angle, 3 mm beryllium filter) at a beam current of 10 mA. The beam was seasoned (ramped up to full parameters) from 15:55 to 16:05 NZST on 22 July 2026, and held at full 320 kV/10 mA output until switch-off at 19:26 NZST, giving 3 h 21 min (12060 s) of full-power exposure.

The sensors were irradiated unpowered, still sealed in their cut-tape packaging (a dark plastic carrier tape closed with a thin cover film), so all pins were floating. They were irradiated alongside another experiment, taped to the back of its polystyrene enclosure, so the beam passed through several layers before reaching them (Figure 12). The sensors themselves were outside the enclosure, at room temperature. For the dose calculation, made by the researcher running the exposure, this path was approximated as 315mm of air followed by 5mm of aluminium, with the sensor modelled as a block of silicon. This gives a dose rate of 0.0338Gys⁻¹ in
silicon (3.38rad(Si)/s) and, over the 12060s of full-power exposure, a total of 407.6Gy, or 40.76krad(Si).
X-ray tube | Air

Polystyrene
wall

Liquid
nitrogen

Other
board

Aluminium mount

Liquid
nitrogen

Polystyrene
wall

CT100s in
cut tape
(a) Actual beam path
X-ray tube | Air
315 mm

Aluminium, 5 mm

Silicon
block (b) Path assumed in the dose calculation

Figure 12: Beam path during irradiation (a) and the simplified path used to calculate the dose rate (b). The layers left out of (b) all absorb part of the beam.

The dose is an estimate, and its uncertainty could not be quantified because no dosimeter was placed at the sensors. Its direction is clearer than its size. The calculation leaves out the two polystyrene walls, the liquid nitrogen, the other board, the carrier tape and the mould compound around the die, all of which absorb part of the beam, so the true dose is most likely lower than calculated. It also leaves out the ten-minute ramp-up, which adds a little. The figure of 40.76krad(Si) is therefore best read as an upper estimate. The finding that no change occurred does not depend on its exact value, but comparisons with other dose levels do.


Figure 13: Comparison of the dose rates found in the radiation environments and the rates used in the testing of components for tolerance.

To place this exposure in context, Figure 13 compares the dose rates found in space with those used for testing, following the radiation hardness assurance framework of Poivey [29]. Natural environments such as low Earth orbit and geostationary orbit deliver dose at very low, continuous rates, below 10⁻³
rad(Si)/s, so ground tests use much higher rates to accumulate a mission dose in hours. The rate used here, 3.38rad(Si)/s (12.2krad(Si)/h), lies inside the standardrate window of 3.6 to 36krad/h (1 to 10rad/s) of the European total-dose test method, ESCC 22900 [30]. The test was not, however, an ESCC 22900 test: that method specifies a cobalt-60 gamma or electron-accelerator source rather than X-rays, and it requires parts to be held at their worst-case bias throughout exposure [30]. The result therefore shows whether this dose causes a measurable permanent change in the tested sensors under these conditions; it is not a qualification of the part for flight.

### 9.3 Sensor-Only Board Saturation Response Post-Irradiation

To evaluate whether radiation exposure alters sensor saturation limits or transient recovery dynamics, two irradiated units (Samples 3 and 4) were driven to magnetic saturation following the methodology established in Section 6.3. Table 6 summarizes the saturation ceilings, baseline offsets, differential swings, and recovery times across all eight trials for both non-irradiated and irradiated sample groups for comparison.

Figure 14 shows the oscilloscope captures for the irradiated samples. Following the same trace colour assignment used in the non-irradiated characterization, the blue waveform (M1) represents the differential output voltage (Vout = X1 − X2), while the yellow (C1) and green (C2) waveforms represent the individual X1 and X2 bridge terminal voltages, respectively.

Table 6: Saturation ceiling and recovery time two irradiated/non-irradiated samples for comparison.

Sample Ceiling (V) Baseline (mV) Swing ∆V (V) Recovery (ms)

1 | −1.126 | −17.4 | 1.108 | 76.5
1 | +1.125 | −12.5 | 1.138 | 74.0
2 | −1.145 | −17.4 | 1.128 | 76.0
2 | +1.125 | −12.5 | 1.138 | 67.5
3 | −1.131 | −22.3 | 1.108 | 70.5
3 | +1.111 | −12.5 | 1.123 | 65.5
4 | −1.145 | −22.3 | 1.123 | 78.0
4 | +1.111 | −22.3 | 1.133 | 85.0


(a) Sample 3: Negative Saturation Recovery | (b) Sample 3: Positive Saturation Recovery


(c) Sample 4: Negative Saturation Recovery | (d) Sample 4 ): Positive Saturation Recovery

Figure 14: Oscilloscope captures displaying post-irradiation saturation voltage clamping and transient relaxation trajectories for irradiated sensor board Samples 3 and 4 across both field polarities.

Averaging across both polarities and units within each group, the non-irradiated group exhibits a mean saturation ceiling of 1.130V compared to 1.124V for the irradiated group, representing a 0.5% difference. The mean recovery time across groups is 73.5ms non-irradiated versus 74.75ms irradiated, a 1.7% difference.

The differences between the groups (0.5% in ceiling and 1.7% in recovery time) are smaller than the differences between the two non-irradiated units themselves, whose ceilings differ by up to 1.8% and whose recovery times differ by up to 9ms (Table 6). The irradiated sensors therefore show no detectable permanent change in ceiling or recovery at the tested dose. Both groups were tested in the same session on 7 October 2026, so the comparison is not affected by session-to-session variation.

### 9.4 Quantitative Sweep on the Integrated Board

After irradiation, one sensor was soldered to an integrated board and the current sweep of Section 8.3 was repeated; the results are listed in Table 7. This sensor had never been exposed to a saturating field, before or after irradiation, so its sweep is free of the offset shift described in Section 11.

Table 7: Irradiated sample current
sweep.
Current (mA) | DMM (mV) | MCU (mV)
−2999.0 | −3.723 | −3.258
−2595.0 | −3.123 | −2.803
−1999.0 | −2.570 | −1.748
−1512.0 | −1.620 | −0.044
−1017.0 | −1.050 | −0.001
−498.0 | −0.100 | 0.463
−0.7 | 0.269 | 0.308
498.0 | 1.130 | 1.749
1017.0 | 1.640 | 2.657
1512.0 | 2.098 | 3.178
1999.0 | 2.720 | 3.298
2595.0 | 3.303 | 4.350
2999.0 | 3.912 | 4.834

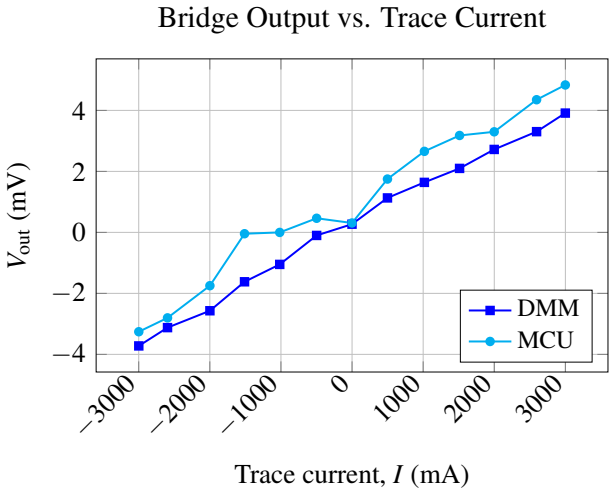
[picture p46: figure]
Trace current, I (mA); Vout (mV); Bridge Output vs. Trace Current; DMM MCU

Figure 15: Plot of irradiated DMM and MCU sweeps detailed in Table 7.

The same linear fit gives 1.269±0.026mVA⁻¹ on the DMM (R

2 = 0.995) and 1.312±0.063mVA⁻¹ on the MCU (R

2 = 0.975), which are 93.6% and 99.8% of the non-irradiated values (Section 8.3). The DMM difference of 6.4% is somewhat larger than the 4% session-to-session variation (Section 10.3) but only 1.2 times the combined standard error of the two fits, and the MCU shows no change at all, so the two instruments do not agree on any change. No significant change in gradient was found at the tested dose, consistent with the junction-level results in Section 2.2. Because the comparison is between two different sensors, a change smaller than the unit-to-unit spread in gradient could not be detected.

### 9.5 Irradiated Saturation Recovery on the Integrated Board

Following the 40.76 krad(Si) Total Ionizing Dose (TID) exposure, the saturation recovery of the integrated board was evaluated with a regulator input of VCC = 5.00V and a measured TMR sensor supply of VDD = 3.289V, the irradiated board was subjected to the same magnetic saturation procedure as in Section 8.2. The resulting recovery waveforms are plotted in Figure 16 and the key metrics are summarized in Table 8. The following irradiated data was collected on the 9th of October 2026.

Table 8: Saturation recovery results, irradiated integrated board (Board B).

Sample Ceiling (V) Baseline (mV) Swing (V) Recovery (ms)

B | −1.146 | 0.0 | 1.146 | 66.7
B | +1.149 | +1.6 | 1.147 | 63.2
(a) Irradiated, negative saturation recovery
(b) Irradiated, positive saturation recovery

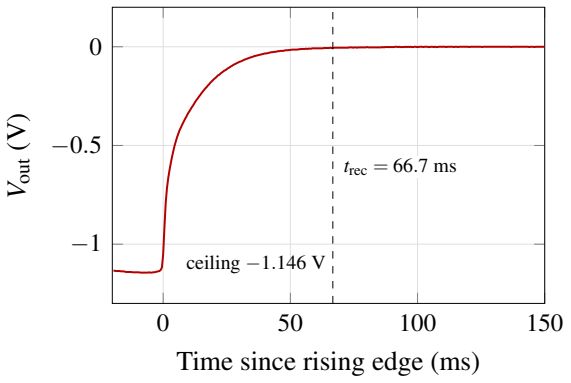
[picture p47: figure]
trec = 66.7 ms; ceiling −1.146 V; Time since rising edge (ms); Vout (V)
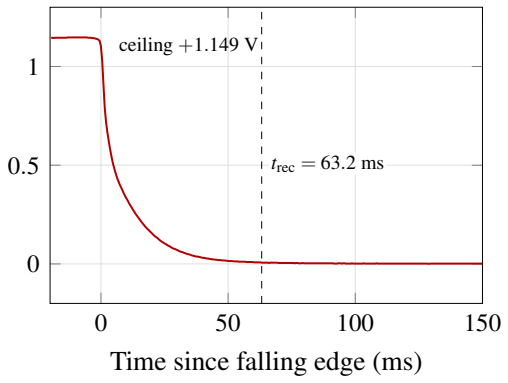
[picture p48: figure]
trec = 63.2 ms; ceiling +1.149 V; Time since falling edge (ms)

Figure 16: Irradiated Saturation recovery on the integrated board after the magnet is removed, for both field directions.

## 10 Magnetic Shielding

### 10.1 Enclosure Design

The enclosure frame was 3D printed in PLA. To check that the printed frame does not affect the field at the sensor, its relative permeability µr was estimated from published measurements of its magnetic susceptibility χ. The susceptibility describes how strongly a material magnetises in an applied field H where the magnetisation is given by M = χH. The flux density in the material is then:
B = µ0(H + M) = µ0(1+ χ)H, | (21)

and comparing this with the definition B = µ0µrH gives:

µr = 1+ χ. | (22)

Sangal et al. measured the susceptibility of common 3D printing polymers and found all of them to be weakly diamagnetic, with χ between about −8.1 and −8.7 parts per million (ppm) for PLA, PETG and ABS [31]. One part per million is 10⁻⁶
, so for PLA, with χ ≈ −8.3 ppm,

µr = 1+ χ = 1+

−8.3×10⁻⁶
≈ 0.9999917. | (23)

This differs from the permeability of free space (µr = 1) by less than 0.001%, so the printed frame has no measurable effect on the field at the sensor. It serves only to hold the ferrite plates and the board in place; all of the shielding comes from the ferrite and nanocrystalline layers.

Surrounding a sensor with a high-permeability material gives magnetic flux a low-reluctance path around the enclosed volume, so an external field is partly diverted away from the sensor. For an ideal closed spherical shell of inner radius a, thickness t ≪ a and relative permeability µr ≫ 1, the field inside is reduced by a factor of about 1+2µr

t/(3a) [32]. A constant ambient field adds only a fixed offset to the output, so shielding is expected to reduce that offset and any noise or drift it causes, not to change the gradient of the response to the trace current (Section 12.6).

Mu-metal, an 80% nickel–iron–molybdenum alloy, is the usual choice for DC and low-frequency shielding because of its very high permeability: for fully annealed material the initial relative permeability is about 50,000 at DC and 100,000 at 60 Hz, with a maximum of about 350,000 and a saturation flux density of 0.74 T [33]. It was not used here because of its cost.

Instead, a MnZn ferrite, TDK (EPCOS) SIFERRIT material N95, was selected as a costeffective alternative. The manufacturer quotes an initial relative permeability µi of 3000 at 25◦C and a saturation flux density BS of 525 mT at 25◦C [34]. Six N95 slabs, each 100 mm × 100 mm × 5 mm, form the walls of the enclosure. With µr = 3000, t = 5mm and an inner radius of about 50 mm, the closed-shell expression above gives an ideal shielding factor near 200, so a closed shell would cut an external field by about two orders of magnitude. This is an upper bound: the quoted permeability is a small-signal value for a ferrite core rather than a measurement at DC in an enclosure, and the real enclosure has seams and a cable cut-out. The ambient fields to be attenuated (tens of microtesla) are far below the 525 mT saturation flux density, so the ferrite stays in its linear region.

Power and data reach the enclosed board through an ST-Link programmer, so a cut-out was designed into the enclosure for the cable. Any gap raises the reluctance of the shield’s flux path and lets ambient flux leak in towards the sensor.

To reduce this flux leakage, the cut-out was covered with a flexible nanocrystalline shielding foil (YNTECH NF, Qingdao Yunlu Energy Technology). The manufacturer describes its nanocrystalline material as an Fe-based soft magnetic material with a high saturation flux density and a permeability about ten times that of ferrite [35], but gives no specific values for this foil. Measured with a digital caliper, the foil is 0.11mm thick including its protective plastic film and about 0.02mm thick with the film removed. The second value is close to the caliper’s 0.01mm resolution, so it is approximate.

Figure 17 shows the enclosure at three stages: the printed chassis, the board mounted inside (Figure 17b), and the final wrapped assembly (Figure 17c).


(a) Enclosure CAD render.


(b) Internal PCB mounting.


(c) Exterior shielding layer.

Figure 17: Development of the magnetic shielding enclosure. (a) The 3D-printed chassis. (b) The integrated sensor board mounted inside. (c) The assembled test configuration wrapped in shielding. Annotations indicate the placement of ferrite plates (F) and flexible nanocrystalline shielding (N).

### 10.2 Shielded Sweep Results

Because the MCU and DMM had already been shown to agree across the full current range (Section 8.4), the shielded sweeps were logged with the MCU alone. Leaving out the DMM also avoided routing extra leads into the enclosure, which would have complicated the setup and added another possible source of stray field. The non-irradiated and irradiated integrated boards were swept inside the enclosure with the same procedure as in Section 8. The irradiated sensor had still not been driven into saturation at this point.

The raw measurement data for both the non-irradiated and irradiated shielded sweeps are detailed in Table 9 and Table 10, respectively. To visualize the effect of the magnetic shielding, Figure 18 compares these shielded sweeps directly against their unshielded counterparts.

These sweeps were performed at VDD = 3.29V.

Table 9: Shielded, non-irradiated current sweep (MCU only): bridge output vs. trace current.

Table 10: Irradiated, shielded current sweep (MCU only): bridge output vs. trace current.

Current (mA) | MCU (mV)
−3043.4 | 8.039
−2522.5 | 8.549
−2057.7 | 9.594
−1540.3 | 9.949
−1040.2 | 11.170
−546.2 | 11.319
−6.3 | 12.705
535.4 | 12.946
996.2 | 13.931
1523.0 | 14.530
2038.1 | 15.532
2486.1 | 16.103
2988.7 | 16.474
Current (mA) | MCU (mV)
−3007.1 | −3.287
−2501.2 | −2.769
−2054.6 | −1.130
−1567.3 | 0.069
−1037.7 | −0.001
−532.1 | 0.107
−6.3 | 1.318
512.5 | 1.699
1011.4 | 2.837
1557.8 | 3.241
2048.6 | 3.933
2560.6 | 4.807
3025.4 | 4.932
(a) Non-irradiated

Trace Current, I (mA); Vout (mV)

Unshielded (1.32 mV/A)
Shielded (1.45 mV/A)
(b) Irradiated

Trace Current, I (mA)

Unshielded (1.31 mV/A)
Shielded (1.34 mV/A)

Figure 18: Shielded vs. unshielded current sweeps (MCU readings) for (a) the non-irradiated and (b) the irradiated sample.

Shielding changes the gradient by +10% on the non-irradiated board and +2.3% on the irradiated board.

### 10.3 Session-to-Session Variance

To measure the repeatability of the method, the shielded sweep on the non-irradiated board was repeated in a separate session, at VDD = 3.29V. The data are listed in Table 11, and Figure 19 plots them with the first shielded sweep to show how the offset and gradient changed between sessions.

Table 11: Validation Sweep: Non-Irradiated Shielded Board

INA Current (mA) | MCU (mV)
−3046.47 | 8.039
−2492.64 | 8.595
−2009.76 | 9.604
−1493.87 | 10.014
−1037.81 | 11.110
−507.16 | 11.312
−4.58 | 12.514
494.27 | 12.888
1055.68 | 13.579
1515.83 | 14.455
2016.78 | 14.890
2487.65 | 15.978
3006.08 | 16.192

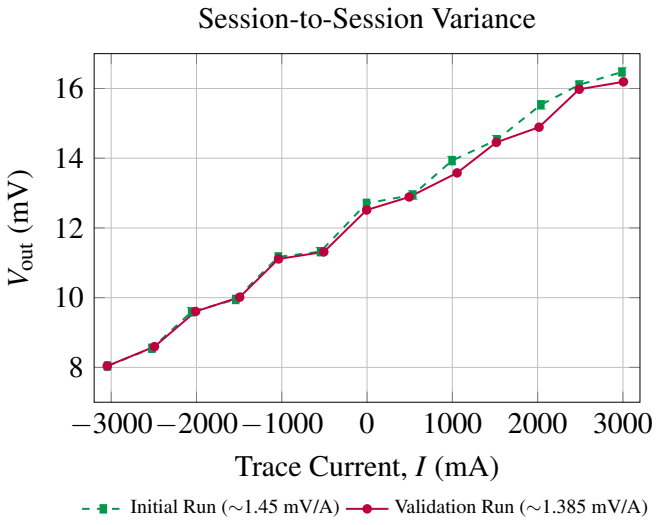
[picture p49: figure]
Trace Current, I (mA); Vout (mV); Session-to-Session Variance; Initial Run (∼1.45 mV/A); Validation Run (∼1.385 mV/A)

Figure 19: Plots of two discrete testing sessions on the same shielded, non-irradiated board.

A linear fit to the validation sweep gives 1.385 ± 0.031mVA⁻¹ . The first shielded run on the same board gave 1.446 ± 0.033mVA⁻¹
(Section 10.2), a difference of 4.2% between two sessions under the same conditions, about 1.3 times their combined standard error. This is the session-to-session variation of the method.

This variation and the ADC step are the yardsticks for the two parts of H6. Offset (H6a). The fitted zero-current offset of the non-irradiated board was 12.60mV unshielded and 12.39 and 12.25mV in the two shielded runs, changes of −0.21 and −0.35mV; on the irradiated board it moved from 1.00 to 1.21mV, a change of +0.21mV (Table 17). All three changes are smaller than one ADC step and smaller than the largest change an ideal shield could cause (about 1mV), so the offset data cannot distinguish an effective shield from no shield. Gradient (H6b). On the irradiated board the gradient changed by +2.3%, well within the session-to-session variation. On the non-irradiated board it changed by +5.3% or +10.0% depending on which shielded run is compared; the smaller value is close to the session-to-session variation and the larger is about twice it. The enclosure therefore does not clearly disturb the test field, although a small concentration of the trace field by the ferrite cannot be ruled out on the non-irradiated board.

## 11 Quantitative Magnetic Hysteresis Testing

To isolate the effects of magnetic history from potential board-level hysteresis, the sensor on the non-irradiated integrated board was desoldered and replaced with a new sensor that had never been exposed to a magnetic field (Board C). All measurements were taken on 12 October 2026 with a regulator input of VCC = 5.00V and a sensor supply of VDD = 3.321V.

The test was run in one session, with no other change to the board, in three steps: (i) a current sweep on the untouched sensor before saturation; (ii) saturation to the negative ceiling and then to the positive ceiling; and (iii) a second, identical current sweep after saturation. The two sweeps are listed in Tables 12 and 13 and plotted in Figure 20. Panel (a) of that figure shows the raw output of both sweeps, and panel (b) shows them again with each sweep’s fitted offset removed so that only the gradient is compared. The saturation events themselves are reported in Table 14 and Figure 21.

Table 12: Before Saturation

INA (mA) | MCU (mV)
−3026.78 | −8.076
−2500.36 | −8.047
−2074.76 | −7.625
−1490.19 | −6.462
−1043.62 | −5.821
−508.79 | −4.869
−6.30 | −4.824
493.28 | −3.809
1003.71 | −3.222
1498.85 | −2.582
2037.68 | −1.641
2510.09 | −1.571
3025.05 | −0.709

Table 13: After Saturation

INA (mA) | MCU (mV)
−2971.20 | 7.896
−2516.89 | 8.091
−2031.67 | 8.878
−1500.70 | 9.660
−999.23 | 10.051
−504.66 | 11.124
−6.15 | 11.297
492.07 | 12.077
1010.23 | 12.875
1504.07 | 13.100
2039.39 | 14.316
2502.52 | 14.558
3018.47 | 15.590
(a) Raw output

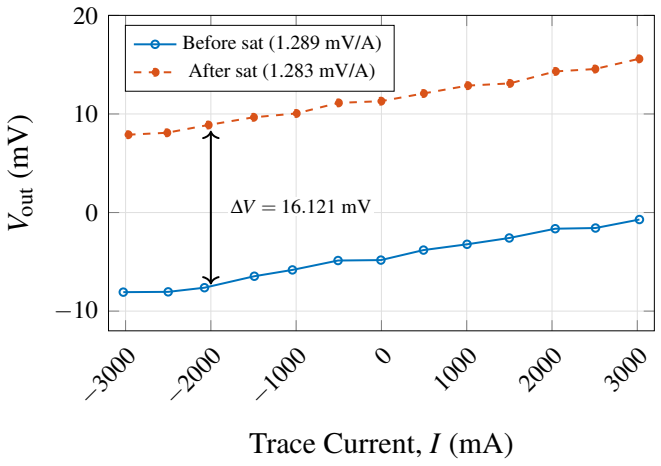
[picture p50: figure]
Trace Current, I (mA); Vout (mV); Before sat (1.289 mV/A); After sat (1.283 mV/A)

(b) Offset removed

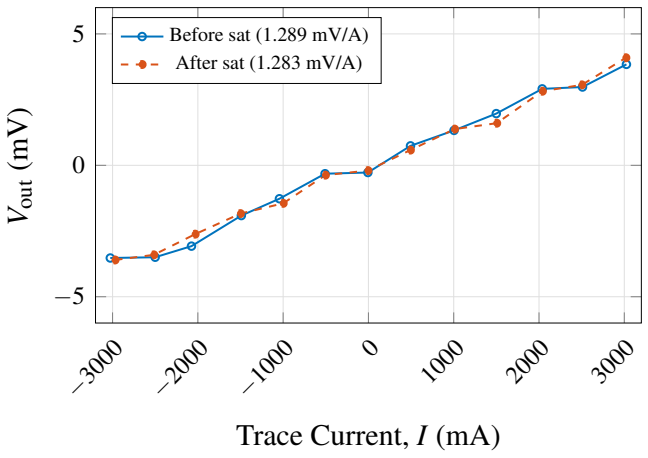
[picture p51: figure]
Trace Current, I (mA); Vout (mV); Before sat (1.289 mV/A); After sat (1.283 mV/A)

Figure 20: Current sweep on a fresh, never-saturated sensor before (solid) and after (dashed) being driven to saturation. (a) Raw output: the curve moves up by 16.121 mV. (b) With offset removed, sweeps overlap.

Table 14: Saturation recovery results, fresh sensor on the integrated board (Board C).

Sample Ceiling (V) Baseline (mV) Swing (V) Recovery (ms)

C | −1.107 | −1.6 | 1.105 | 40.1
C | +1.117 | +11.3 | 1.105 | 48.7
(a) Negative saturation recovery
(b) Positive saturation recovery

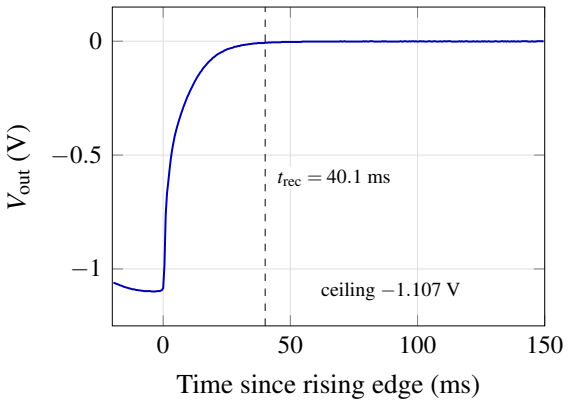
[picture p52: figure]
trec = 40.1 ms; ceiling −1.107 V; Time since rising edge (ms); Vout (V)
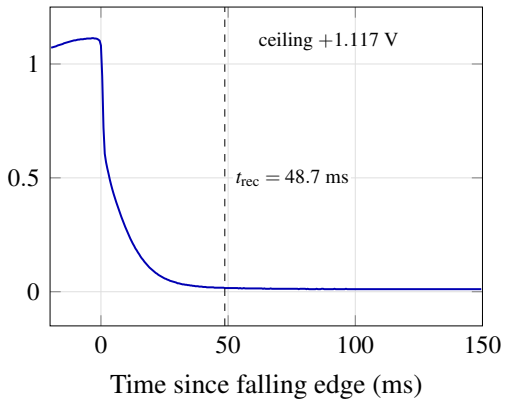
[picture p53: figure]
trec = 48.7 ms; ceiling +1.117 V; Time since falling edge (ms)

Figure 21: Newly Soldered Non-Irradiated Saturation recovery on the integrated board after the magnet is removed, for both field directions.

When the saturating magnetic field is removed, the sensor output decays from its respective ceiling (-1.107 V for negative saturation, 1.117 V for positive saturation). Figure 21 tracks this transient response, showing that the sensor settles to within 5 mV of its new baseline in 40.1 ms after the negative event, and 48.7 ms after the positive event.

The zero-field baseline is the output once the field has been removed. Table 15 lists the baseline before and after each saturation event for all three integrated boards, and Figure 22 shows the baseline of Board C through the sequence. “Before” is the median output in a quiet interval before the field was applied, “after” is the median output once recovery was complete, and the shift is after minus before, so a positive shift means the zero-field output moved up. The shifts are computed from unrounded values.

Table 15: Baseline before and after each saturation event, integrated boards.

Sample | Ceiling reached Before (mV) After (mV) Shift (mV)
A (non-irradiated) Negative | −6.4 | −8.1 | −1.6
A (non-irradiated) Positive | −8.1 | +12.9 | +20.9
B (irradiated) | Negative | 0.0 | 0.0 | 0.0
B (irradiated) | Positive | 0.0 | +1.6 | +1.6
C (fresh sensor) | Negative | −4.8 | −1.6 | +3.2
C (fresh sensor) | Positive | −1.6 | +11.3 | +12.9

Three observations follow from Table 15. First, on Board C the negative ceiling moved the baseline by only +3.2mV (two ADC steps of 1.61mV), but the positive ceiling that followed moved it by +12.9mV, leaving the baseline at +11.3mV, a total shift of +16.1mV from the untouched sensor. Second, Board A shows the same pattern, a negligible shift at the negative ceiling and a large one (+20.9mV) at the positive ceiling. Third, the irradiated Board B shows no comparable shift (0.0 and +1.6mV). Because the negative ceiling was always reached first, these data cannot yet separate the direction of the field from the order of the events, and Board B is a single irradiated unit.

[TODO: Second hysteresis test (Board D, positive ceiling first): add two rows to Table 15 (template below), give the before/after sweep gradients and offsets in one sentence, and finish with the sentence that matches the result.]

Gradient stability. Despite the shift in offset, the sensor’s linear response to current is essentially unaffected. A straight-line fit to each sweep gives a gradient of 1.289±0.038 mV/A before saturation and 1.283±0.030 mV/A after, a change of only −0.5%, which is far smaller than the standard error of either gradient. The fitted offset at zero current moves from −4.55 mV to +11.50 mV, a shift of 16.05mV, and R

2
stays above 0.99 (0.991 before and 0.994 after). Saturation therefore moves the whole response up without changing its slope or its linearity. This is the pattern seen in panel (b) of Figure 20, where the two sweeps overlap once their offsets are

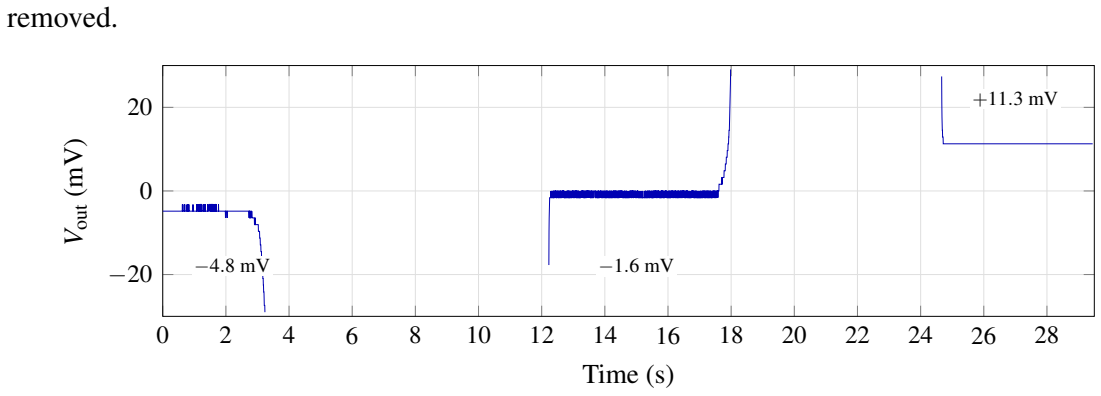
[picture p54: figure]
removed.; Time (s); Vout (mV)

Figure 22: Output baseline before, between and after the two saturation events (view clipped to ±30 mV so the baseline is visible). The baseline moves from −4.8 mV to −1.6 mV after the negative saturation, then to +11.3 mV after the positive saturation.
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
