hye071/P4P_TMR/Report/P4P_Report_claude.pdf

### Department of Electrical, Computer, and Software Engineering The University of Auckland

# Characterisation, Field Modelling, and Radiation Testing of a Commercial Tunnelling Magnetoresistance (TMR) Sensor for CubeSat Attitude Determination and Control

## Final Year Technical Report

### Sam Ye

### Supervisor: Dariusz Kacprzak

### Project Partner: Daniel Tieu

### [TODO: insert submission date]

## Acknowledgements

The author thanks project supervisor Dariusz Kacprzak for guidance throughout this project, and project partner Daniel Tieu for his work on the parallel thermal-cycling test campaign. [TODO: Add any further acknowledgements – e.g. workshop/lab staff, the radiationtesting facility or operator, or funding sources – once confirmed.]

## Abstract
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
