hye071/P4P_TMR/Report/sat_figures.tex

% ============================================================
% Preamble (if not already present):
%   \usepackage{pgfplots}
%   \usepgfplotslibrary{groupplots}
%   \pgfplotsset{compat=1.18}
% Put rec_*.csv and trace_*.csv in the same folder as main.tex.
% ============================================================

% ---------- Figure A: the four recovery transients ----------
\begin{figure}[h]
\centering
\begin{tikzpicture}
\begin{groupplot}[
    group style={group size=2 by 2, horizontal sep=1.5cm, vertical sep=1.7cm},
    width=0.48\textwidth, height=0.36\textwidth,
    xmin=-20, xmax=150, grid=major, grid style={gray!25}, axis lines=box,
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
