hye071/P4P_TMR/Data/FAST_P01.PNG

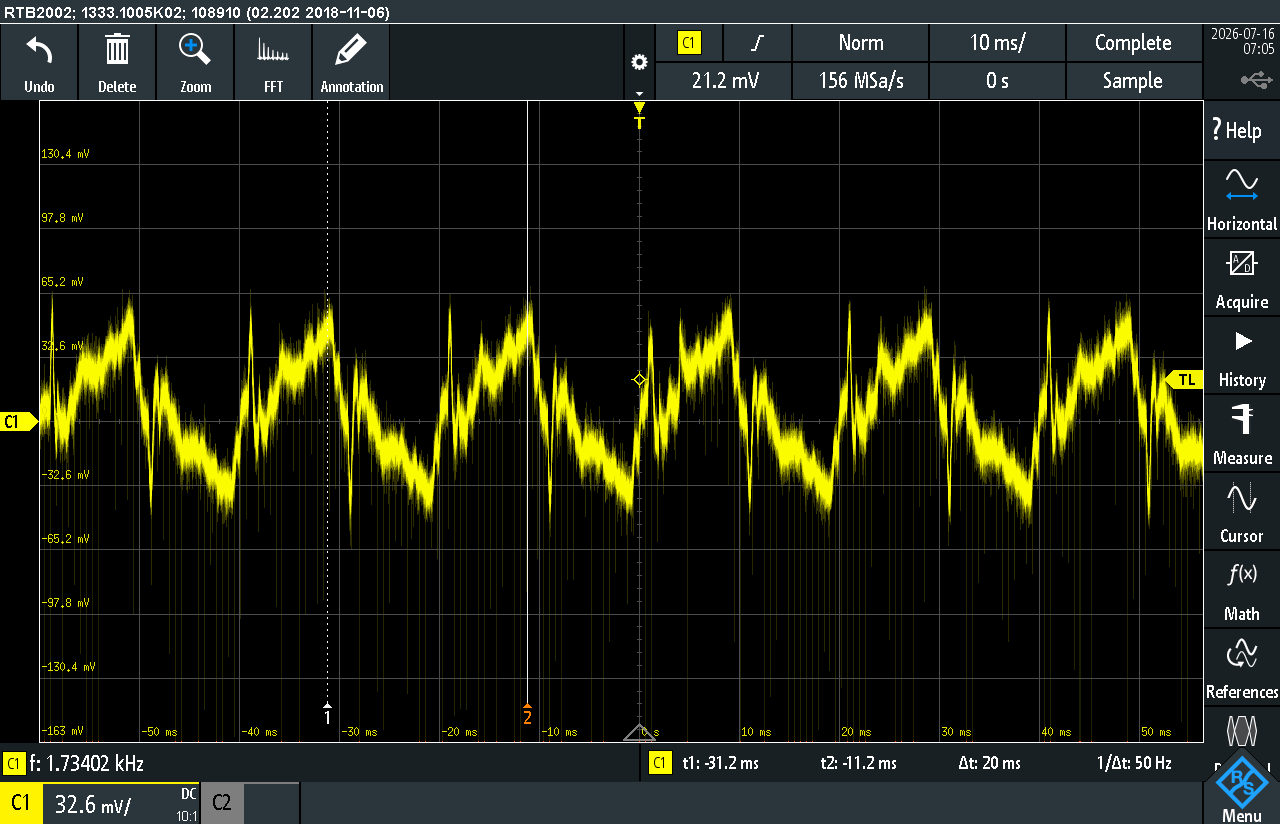
Data/FAST_P01.PNG
