hye071/P4P_TMR/Data/No_faracage.PNG

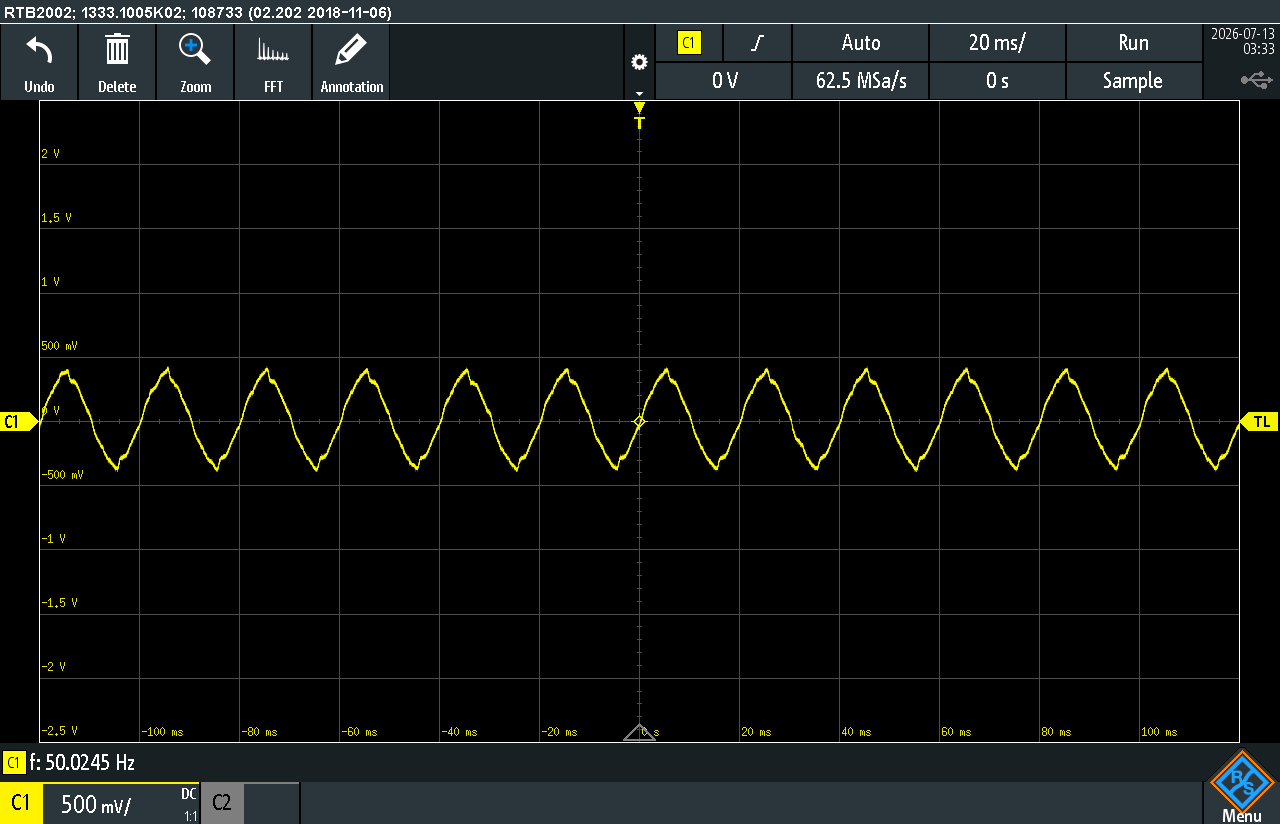
Data/No_faracage.PNG
