hye071/P4P_TMR/Report/CT100_eletrical_char.png

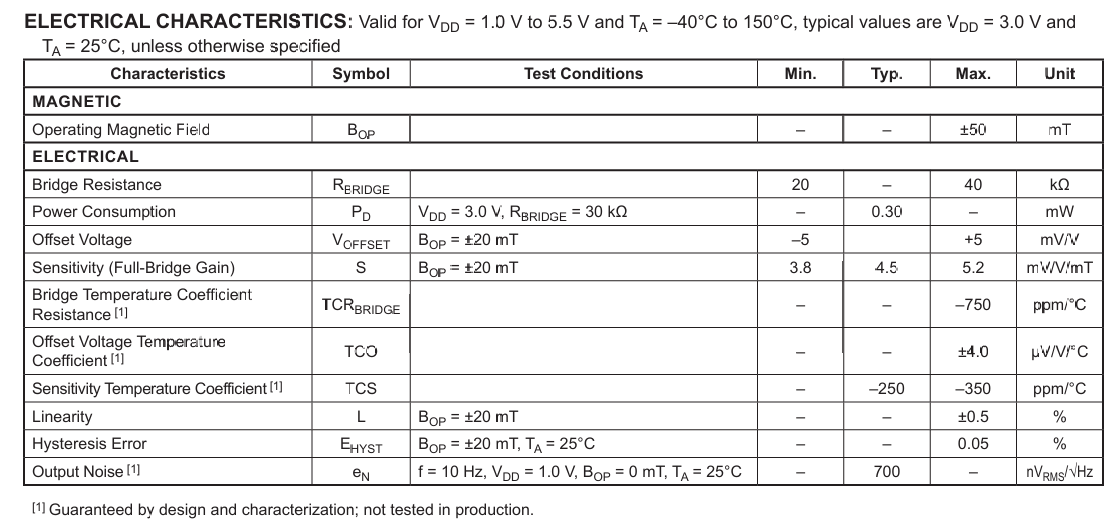
Report/CT100_eletrical_char.png
