hye071/P4P_TMR/Report/response.png

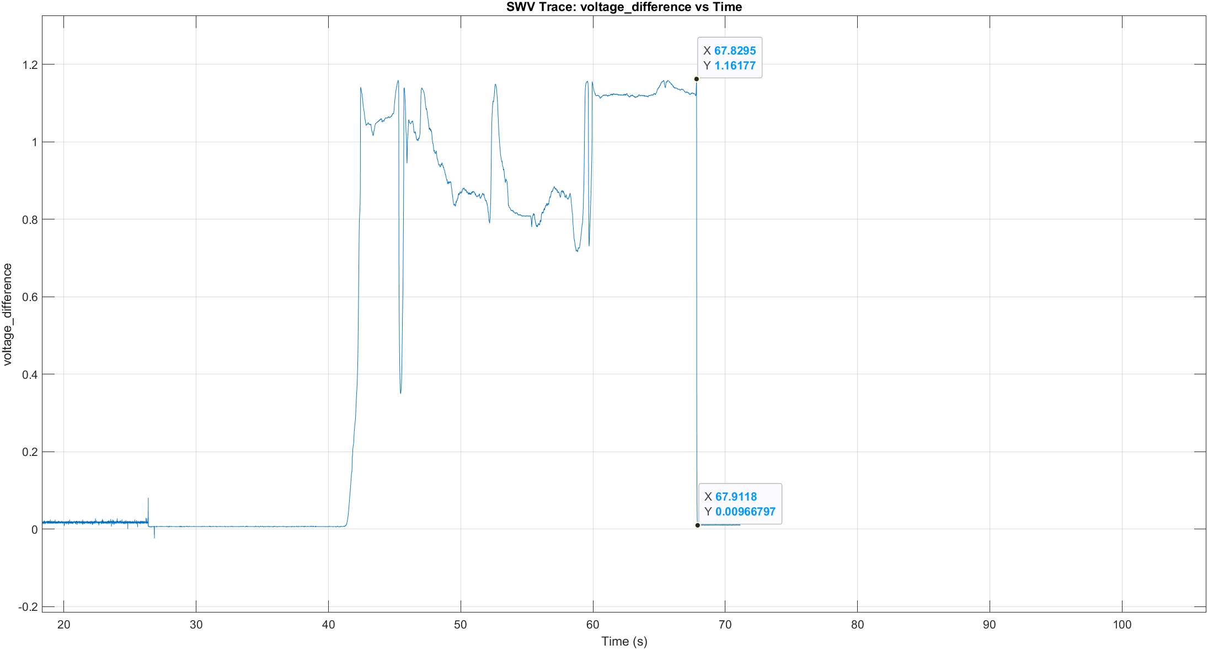
Report/response.png
