hye071/P4P_TMR/Report/scope_x1-x2_compare_code.PNG

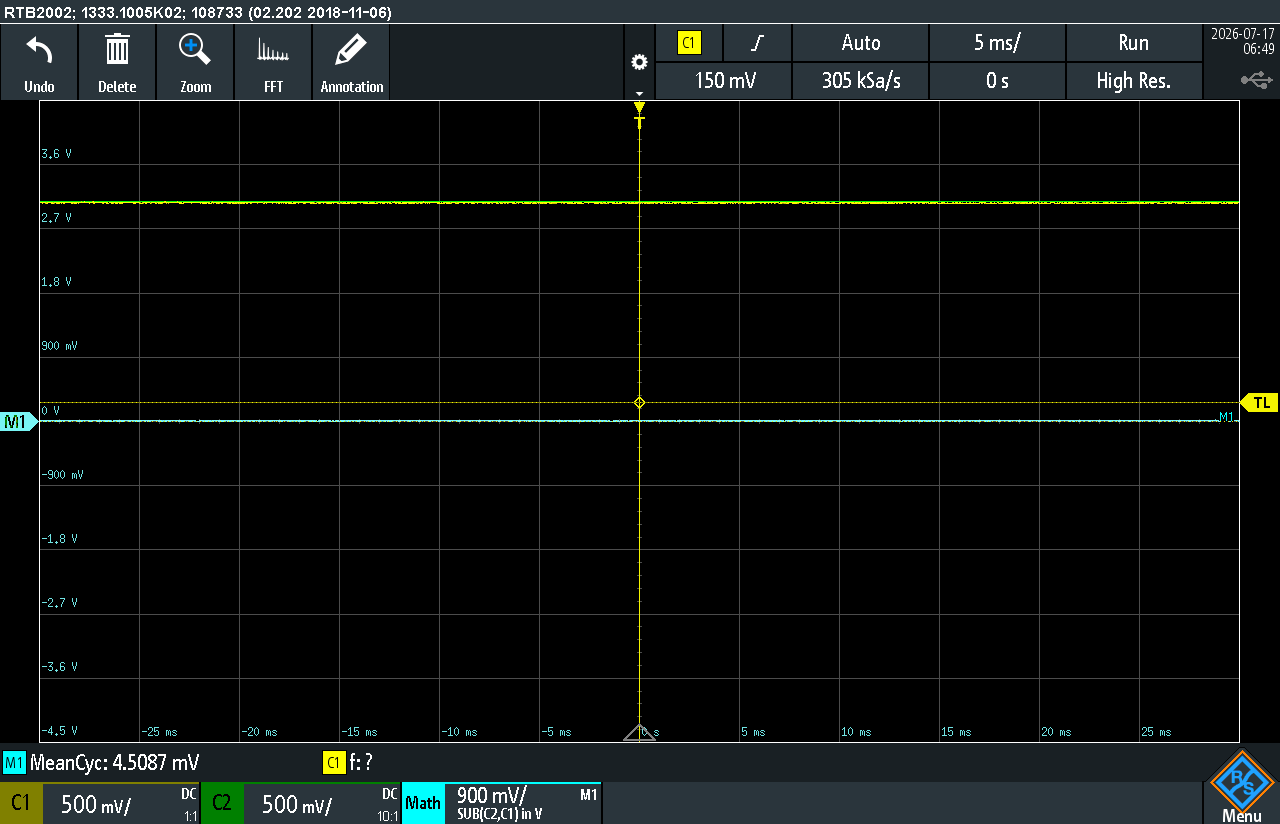
Report/scope_x1-x2_compare_code.PNG
