hye071/P4P_TMR/CAD/TMR_Shielding/Box_v2.stl

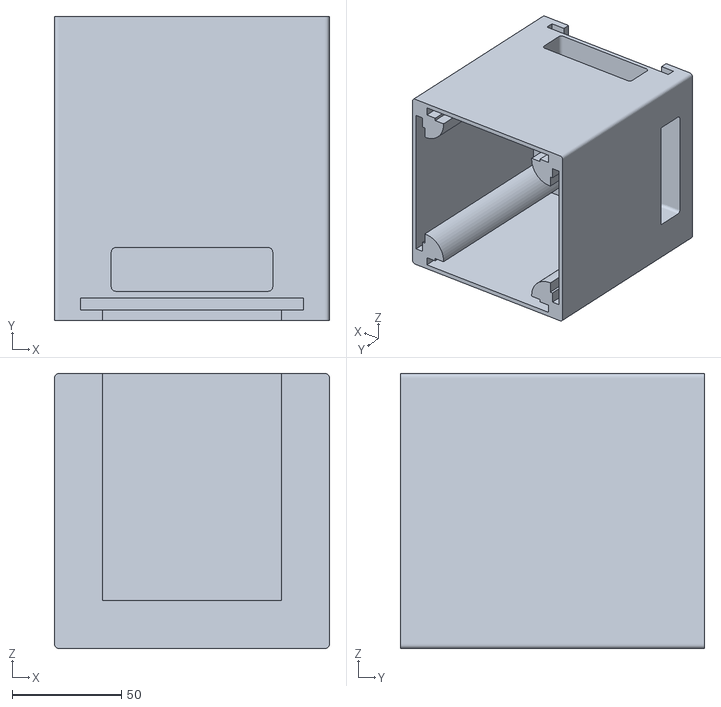
[picture p60: CAD file, 2026-09-22]
CAD/TMR_Shielding/Box_v2.stl
126.0 x 139.5 x 126.0
