hye071/P4P_TMR/CAD/TMR_Shielding/Lid_v2.stl

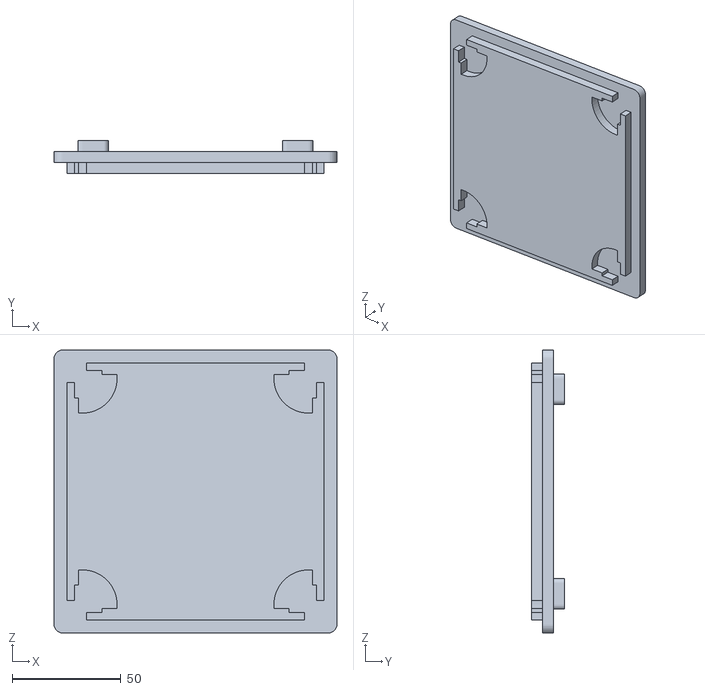
[picture p61: CAD file, 2026-09-22]
CAD/TMR_Shielding/Lid_v2.stl
130.0 x 15.0 x 130.0
