hye071/P4P_TMR/CAD/TMR_Shielding/Plastic_Lining_v2.stl

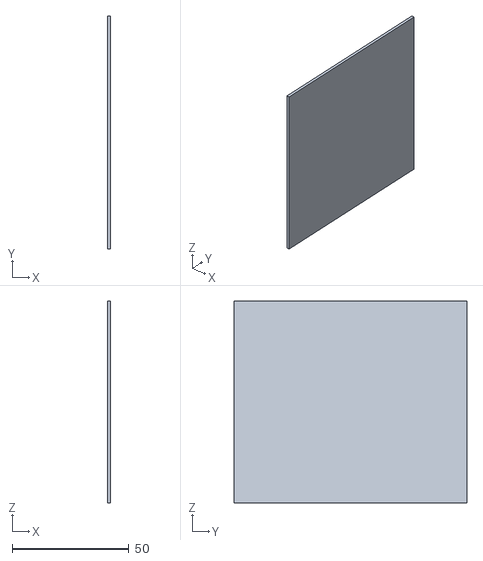
[picture p62: CAD file, 2026-09-22]
CAD/TMR_Shielding/Plastic_Lining_v2.stl
1.50 x 100.0 x 86.5
