hye071/P4P_TMR/(list of files, cad)

Other CAD files:
CAD/TMR_Shielding/Box_v2.ipt
CAD/TMR_Shielding/Chink_Box_FINAL.ipt
CAD/TMR_Shielding/LID_v2.ipt
CAD/TMR_Shielding/Plastic Lining_v2.ipt
