hye071/P4P_TMR/Data/testing1.png

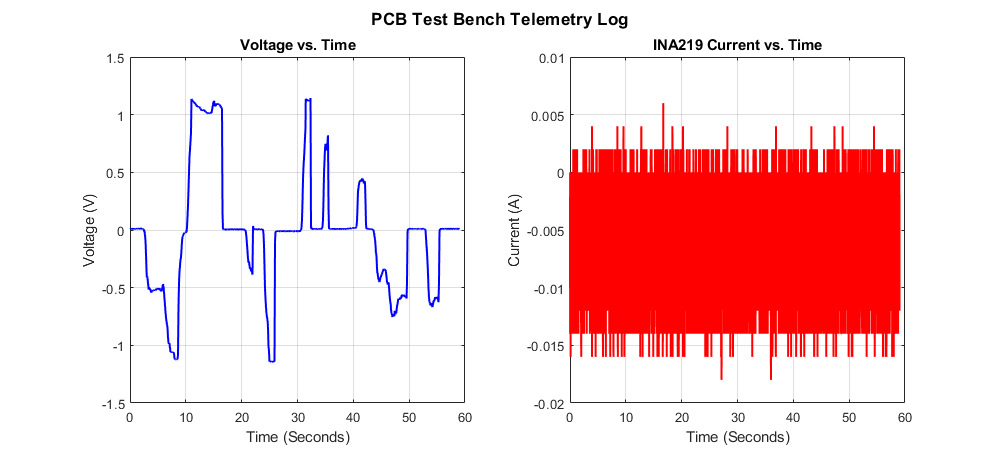
Data/testing1.png
