hye071/P4P_TMR/(list of files, drawings)

Other design files:
Altium/TMR_MAGSAT/TMR_MAGSAT.PcbDoc
Altium/TMR_MAGSAT/TMR_MAGSAT.PrjPcb
Altium/TMR_MAGSAT/TMR_MAGSAT.SchDoc
Altium/TMR_Radiation_Compare/TMR_RAD_COMPARE.PcbDoc
Altium/TMR_Radiation_Compare/TMR_RAD_COMPARE.PrjPcb
Altium/TMR_Radiation_Compare/TMR_RAD_COMPARE.SchDoc
Daniel/H_Bridge/H_Bridge.PrjPcb
Daniel/H_Bridge/H_Bridge.SchDoc
Daniel/H_Bridge/H_Bridge_STM32.SchDoc
Daniel/H_Bridge/PCB1.PcbDoc
Daniel/TMR/PCB1.PcbDoc
Daniel/TMR/Sheet1.SchDoc
Daniel/TMR/TMR.PrjPcb
