hye071/P4P_TMR/Firmware/TMR_MAGSAT/MAG_SAT_firm_project/Core/Src/main.c

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
/* Includes ------------------------------------------------------------------*/
#include "main.h"

/* USER CODE BEGIN Includes */
#include <stdio.h>
#include <stdlib.h>


/* USER CODE END Includes */

ADC_HandleTypeDef hadc1;

I2C_HandleTypeDef hi2c1;

/* USER CODE BEGIN PV */

volatile uint32_t adc_value = 0;
volatile float voltage_difference = 0.0f;
volatile float current_amps = 0.0f;

const float V_REF = 3.3f;
uint8_t raw_current_bytes[2] = {0};
int16_t raw_current_value = 0;


/* USER CODE END PV */

void SystemClock_Config(void);
static void MX_GPIO_Init(void);
static void MX_ADC1_Init(void);
static void MX_I2C1_Init(void);
/* USER CODE BEGIN 0 */

// Redirect printf to the SWV/ITM hardware trace port
int __io_putchar(int ch)
{
    // This built-in CMSIS function automatically targets ITM Stimulus Port 0
    ITM_SendChar(ch);
    return ch;
}


/* USER CODE END 0 */

/**
  * @brief  The application entry point.
  * @retval int
  */
int main(void)
{


  /* USER CODE END 1 */

  /* MCU Configuration--------------------------------------------------------*/

  /* Reset of all peripherals, Initializes the Flash interface and the Systick. */
  HAL_Init();

  /* Configure the system clock */
  SystemClock_Config();

  /* Initialize all configured peripherals */
  MX_GPIO_Init();
  MX_ADC1_Init();
  MX_I2C1_Init();
  /* USER CODE BEGIN 2 */

  // Run automatic calibration for ADC1 in Differential Mode
   if (HAL_ADCEx_Calibration_Start(&hadc1, ADC_DIFFERENTIAL_ENDED) != HAL_OK)
   {
       /* Calibration Error Handling */
       Error_Handler();
   }

   //INA219 Programming calibration registers
 #define INA219_ADDR (0x40 << 1) //slave address
 #define REG_CAL  0x05
 #define REG_CURRENT   0x04

   uint8_t cal_data[2] = {0xA0, 0x00};
   HAL_I2C_Mem_Write(&hi2c1, INA219_ADDR, REG_CAL, I2C_MEMADD_SIZE_8BIT, cal_data, 2, 100);

   //Variables set up
//   uint32_t adc_value = 0;
//   float voltage_difference = 0.0f; //X1-X2(V)
//   const float V_REF = 3.3f; //Board reference voltage (3V3) (V)
//   float current_amps = 0.0f; //shunt current(A)
//   uint8_t raw_current_bytes[2] = {0};
//   int16_t raw_current_value = 0;

  /* USER CODE END 2 */



  /* Infinite loop */
  /* USER CODE BEGIN WHILE */
  while (1) //code doesn't wipe while in while loop
  {

	  //generates raw differitianal ADC values from TMR sensor
	  HAL_ADC_Start(&hadc1);

	      if (HAL_ADC_PollForConversion(&hadc1, 10) == HAL_OK) {
	          adc_value = HAL_ADC_GetValue(&hadc1);
	      }
	      HAL_ADC_Stop(&hadc1);

	      //Converting Raw ADC to Analog Voltage
	      voltage_difference =  ((float)adc_value - 2048.0f) / 2048.0f * V_REF;


	      //Using LED to determine polarity of the field




	      //  Read directly from the Current Register (0x04)
	      if (HAL_I2C_Mem_Read(&hi2c1, INA219_ADDR, REG_CURRENT, I2C_MEMADD_SIZE_8BIT, raw_current_bytes, 2, 100) == HAL_OK) {
	          raw_current_value = (int16_t)((raw_current_bytes[0] << 8) | raw_current_bytes[1]);

	          // Multiply by our chosen Current_LSB (0.0002f) to get real Amperes
	          current_amps = (float)raw_current_value * 0.0002f;
	      }


    // debugging LEDs testing code

//	  HAL_GPIO_TogglePin(GPIOA, GPIO_PIN_8); // Toggle Pin
//	  HAL_Delay(500); // Delay 500ms
//
//	  HAL_GPIO_TogglePin(GPIOA, GPIO_PIN_12); // Toggle Pin
//	  HAL_Delay(500); // Delay 500ms

	  /* Terminal Output via SWO Programmer */

//	      	HAL_Delay(10); // Delay 10ms
	    //  	printf("%d,%.4f,%.3f\r\n", HAL_GetTick(), voltage_difference, current_amps);


  }
}

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
