hye071/P4P_TMR/Firmware/TMR_MAGSAT/MAG_SAT_firm_project/MAG_SAT_firm_project.ioc

Mcu.UserName=STM32G431KBTx
PA0.GPIO_Label=X1
PA0.Signal=ADC1_IN1
PA1.GPIO_Label=X2
PA1.Signal=ADC1_IN2
PA12.GPIO_Label=debug_LED2
PA12.Signal=GPIO_Output
PA13.Signal=SYS_JTMS-SWDIO
PA14.Signal=SYS_JTCK-SWCLK
PA15.Signal=I2C1_SCL
PA8.GPIO_Label=debug_LED1
PA8.Signal=GPIO_Output
PB3.Signal=SYS_JTDO-SWO
PB7.Signal=I2C1_SDA
