hye071/P4P_TMR/Firmware/TMR_MAGSAT/MAG_SAT_firm_project/Core/Inc/main.h

#define X1_Pin GPIO_PIN_0
#define X1_GPIO_Port GPIOA
#define X2_Pin GPIO_PIN_1
#define X2_GPIO_Port GPIOA
#define debug_LED1_Pin GPIO_PIN_8
#define debug_LED1_GPIO_Port GPIOA
#define debug_LED2_Pin GPIO_PIN_12
#define debug_LED2_GPIO_Port GPIOA
