hye071/P4P_TMR/(commit log)

2026-05-14 created PCB project for magsat test
    [TMR_MAGSAT.PrjPcb, TMR_MAGSAT.SchDoc]
2026-06-21 saving work for schmatic
    [TMR_MAGSAT.PrjPcb, TMR_MAGSAT.SchDoc]
2026-06-22 Finished TMR DC Current REF schamtic
    [TMR_MAGSAT.PrjPcb, TMR_MAGSAT.SchDoc]
2026-06-23 Fixed I2C for MCU connection and finished PCB schematic
    [TMR_MAGSAT.SchDoc]
2026-06-23 generated PCB
    [TMR_MAGSAT.PcbDoc, TMR_MAGSAT.SchDoc]
2026-06-23 did initial placements for PCB
    [TMR_MAGSAT.PcbDoc, TMR_MAGSAT.PrjPcb, TMR_MAGSAT.SchDoc]
2026-06-24 saving work did some routing and added polygons and what not
    [TMR_MAGSAT.PcbDoc, TMR_MAGSAT.SchDoc]
2026-06-25 finished pcb routing need to make it look cleaner
    [TMR_MAGSAT.PcbDoc, TMR_MAGSAT.SchDoc]
2026-06-25 finished making PCB made it look rounded
    [TMR_MAGSAT.PcbDoc]
2026-06-25 added silk screen to PCB looks clean now
    [TMR_MAGSAT.PcbDoc, TMR_MAGSAT.SchDoc]
2026-06-25 PCB project ready to be gerbered
    [TMR_MAGSAT.PcbDoc, TMR_MAGSAT.PrjPcb]
2026-06-28 added debug LEDs and generated gerbers
    [TMR_MAGSAT.GBL, TMR_MAGSAT.GBO, TMR_MAGSAT.GBP, TMR_MAGSAT.GBS, TMR_MAGSAT.GKO, TMR_MAGSAT.GM1, TMR_MAGSAT.GTL, TMR_MAGSAT.GTO]
2026-07-01 created a stm32 project for magsat project
    [TMR_MAGSAT.PrjPcb]
2026-07-01 finished writing MAGSAT code system build and compiled and ready for testing
    [TMR_MAGSAT.PcbDoc, TMR_MAGSAT.SchDoc]
2026-07-07 created a TMR_rad_compare PCB
    [TMR_RAD_COMPARE.PcbDoc, TMR_RAD_COMPARE.PrjPcb, TMR_RAD_COMPARE.SchDoc]
2026-07-07 Got rid of design rule error ready to be gerbered
    [TMR_RAD_COMPARE.PcbDoc, TMR_RAD_COMPARE.SchDoc]
2026-07-07 saving work ready to be gerber
    [TMR_RAD_COMPARE.PcbDoc, TMR_RAD_COMPARE.SchDoc]
2026-07-07 chnaged board size
    [TMR_RAD_COMPARE.PcbDoc]
2026-07-07 saving work
    [TMR_RAD_COMPARE.PcbDoc]
2026-07-07 ready to be gerberd
    [TMR_RAD_COMPARE.PcbDoc]
2026-07-07 generated gerber files for TMR_RAD_COMPARE
    [TMR_RAD_COMPARE.GBL, TMR_RAD_COMPARE.GBO, TMR_RAD_COMPARE.GBP, TMR_RAD_COMPARE.GBS, TMR_RAD_COMPARE.GKO, TMR_RAD_COMPARE.GM1, TMR_RAD_COMPARE.GTL, TMR_RAD_COMPARE.GTO]
2026-07-14 got serial viewer to work need to calibrate
    [MAG_SAT_firm_project Debug.cfg]
2026-07-16 added data folder for images and such
    [telemetry.csv]
2026-07-20 did anys simulation and testing of board
    [telemetry.csv, telemetry1 - Copy.csv, telemetry1.csv, telemetry2.csv, telemetry3.csv]
2026-07-23 created a matlab script to parse the data logs of the SWV
    [telemetry.csv, telemetry1 - Copy.csv, telemetry1.csv, telemetry2.csv, telemetry3.csv]
2026-08-04 H Bridge
    [H_Bridge.PrjPcb, PCB1.PcbDoc, Sheet1.SchDoc, TMR.PrjPcb]
2026-08-24 Overall schematic done
    [Sheet1.SchDoc]
2026-09-01 H bridge with DEV board
    [H_Bridge.PrjPcb, Sheet1.SchDoc, Sheet2.SchDoc]
2026-09-01 Finished H-Bridge
    [H_Bridge.SchDoc, H_Bridge_STM32.SchDoc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]
2026-09-02 Finished H bridge routing
    [H_Bridge.SchDoc, PCB1.PcbDoc]
2026-09-06 collected data for instrmentaion
    [MAGSAT_Data.xlsx]
2026-09-22 created CAD for TMR sheilding
    [Box_v2.ipt, Box_v2.stl, Chink_Box_FINAL.ipt, LID_v2.ipt, Lid_v2.stl, Plastic Lining_v2.ipt, Plastic_Lining_v2.stl]
2026-09-24 collected data for sheilding for non-radited board
2026-10-07 saving sensor only saturation data postive and negative voltage
2026-10-09 collected rad satuation data on inetragte board
    need to desolder new tmr and then current sweep, saturate then current sweep again
