hye071/P4P_TMR/(notices)

Notices in the files:
Firmware/TMR_MAGSAT/MAG_SAT_firm_project/Core/Inc/main.h:
© Copyright (c) 2026 STMicroelectronics.
All rights reserved.
This software component is licensed by ST under BSD 3-Clause license,
the "License"; You may not use this file except in compliance with the
License. You may obtain a copy of the License at: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
(C) COPYRIGHT STMicroelectronics *****END OF FILE
